RoozbehAmini/NTC-Thermistor-Temperature-Measurement-and-Calibration-System/Lab6_Project_Report.pdf

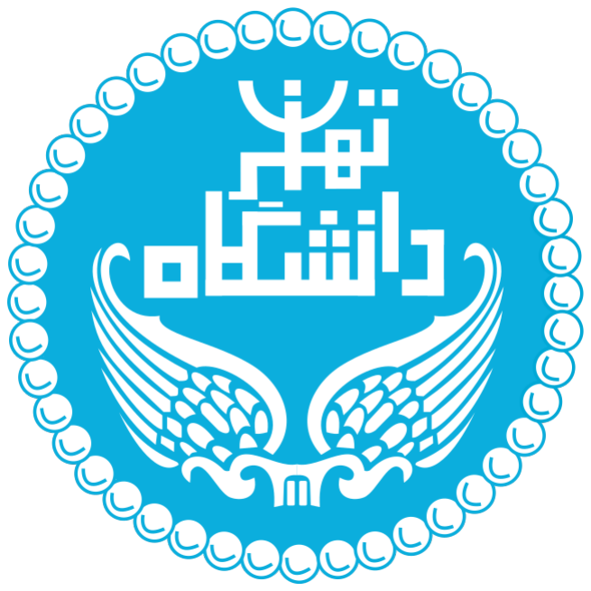
[picture p1: figure]

# Measurement Systems

# Lab Report 6

## Instructor: Dr. Ali Sadighi

## Author: Roozbeh Amini - 810601291

February 19, 2026

Session #6: Thermistor Temperature Measurement Measurement Systems Lab Report

Abstract

This report describes the design, calibration and verification of a temperature measurement system for 0–100 °C, built around a 10 kΩ NTC thermistor, a unity-gain difference amplifier and an Arduino Uno. The only reference thermometer available was a medical thermometer that reads between 32 and 43 °C, so all intermediate calibration points had to be taken in that range. The 0 °C point came from an ice bath. The high-end point came from boiling water, whose temperature was estimated as about 90 °C because of Tehran’s altitude and the cooling of the water after boiling. Eight calibration points were recorded at 50 Hz for 60 s each, and the mean of the last 10 s of each record was used as the steady-state value.
The ice bath reading, Vth(0 °C) = 3.73 V, was used as the reference voltage of the difference amplifier (Figure 8). Fitting the β-parameter model gave β = 3578.29 K and R0 = 9835.46 Ω. Evaluating the model at 100 °C gives Vth(100 °C) = 0.405 V and an amplifier output of 3.325 V. This value was used as the external ADC reference (VAREF = 3.325 V), so the full ADC range covers 0–100 °C with a resolution of 3.25 mV per step, 33.5% finer than with the default 5 V reference. The 1 MΩ amplifier input resistors are about 134 times the worst-case source impedance of the divider (7 468 Ω), well above the usual 10× rule. In the final test, the system read +0.44 °C in the ice bath and 34.32 °C in a bath where the medical thermometer read 34.4 °C, a difference of 0.08 °C.

## Contents

1 Introduction | 5
2 Theoretical Background | 5
3 Thermistor Calibration | 10
4 Circuit Design and Signal Conditioning | 21

5 Firmware Implementation | 29
6 Results and Verification | 30
7 Discussion | 31
8 Conclusion | 34
Acknowledgements | 35
Appendices | 37
A Arduino Calibration Logger (50 Hz, 60 s) | 37
B Live Voltage Reader | 38
C MATLAB Calibration Acquisition Script | 39
D MATLAB Model Fitting and Characteristic Plots | 41
E Final Temperature Measurement Firmware | 44

## List of Figures

1 | Typical NTC thermistor resistance vs. temperature characteristic [1]. . . . | 5
2 | The 10 kΩ NTC thermistor used in this experiment | | 6
3 | Voltage divider schematic: two series resistors between Vcc and GND pro-
| duce a node voltage proportional to the lower resistance | | 7
4 | Wheatstone bridge schematic [1]. At balance the differential voltage is
| VD = 0. When the bridge is unbalanced, as in sensor applications, VD
| changes with the deviation of Rx from its nominal value | | 8
5 | Difference amplifier schematic [1]. With all four resistors equal the output
| is Vout = V2 − V1 | | 9
6 | Three-op-amp instrumentation amplifier topology [1]. The gain is set by
| the single resistor RG | | 9
7 | Calibration setup. Both sensors were kept in the bath until the medical
thermometer showed a stable reading, and then the 60 s recording was started. 12
8 | 60 s recording at 0 °C (ice bath). The rising transient is the thermistor
| cooling from room temperature. Steady-state mean: Vth = 3.7300 V, Rth =
29,498.05 Ω | 14
9 | 60 s recording at 33.2 °C. Steady state: Rth = 7,241.27 Ω | 15
10 | 60 s recording at 34.4 °C. Steady state: Rth = 6,832.37 Ω | 15
11 | 60 s recording at 35.3 °C. Steady state: Rth = 6,585.11 Ω | 16
12 | 60 s recording at 37.0 °C. Steady state: Rth = 6,135.16 Ω | 16
13 | 60 s recording at 37.8 °C. Steady state: Rth = 5,944.50 Ω | 17
14 | 60 s recording at 38.2 °C. Steady state: Rth = 5,892.11 Ω | 17
15 | 60 s recording in boiling water (estimated 90 °C). The sharp initial drop
| is followed by a flat plateau. Steady state (last 10 s): Vth = 0.5100 V,
Rth = 1,135.84 Ω | 18
16 Calibration curve: measured points (red) and fitted β-model (blue). The
model is extrapolated to 100 °C to find VAREF | 19
17 | Expected thermistor characteristics from the fitted model over 0–100 °C.
| Left: resistance R(T). Right: divider output Vth(T) for Vcc = 5 V and
R1 = 10 kΩ. The calibration points are shown on both plots | 20
18 Stage 1 thermistor voltage divider wiring. The Vth node is connected by a
jumper to the inverting input of Stage 3 | 22
19 | Stage 3 difference amplifier wiring. All four resistors are 1 MΩ. Inverting
| input: Vth from Stage 1. Non-inverting input: Vref = 3.73 V from Stage 2.
Output to Arduino A0 | 24
20 Stage 4 AREF wiring, with the 5 kΩ protection resistor between the po-
tentiometer wiper and the AREF pin | 27
21 | Complete measurement circuit: (a) schematic and (b) breadboard. The
| breadboard follows the left-to-right order of the schematic. A walkthrough
video is available at [4] | 28

## 1. Introduction

NTC (negative temperature coefficient) thermistors are common in mechatronic instrumentation because they are sensitive, cheap and small [1]. Their resistance changes with temperature in a strongly nonlinear way, so a calibration model and some signal conditioning are needed before the signal can be read by a microcontroller ADC.

This report follows the workflow given in the course manual [1]: characterising the thermistor, designing the signal conditioning circuit and checking its loading, fitting a model in MATLAB, and running calibrated firmware on an Arduino Uno. Calibration is presented before the circuit design, because the two design voltages come from it: the difference amplifier reference Vref = 3.73 V and the external ADC reference VAREF = 3.325 V are both based on the calibration measurements and the fitted model. Neither can be taken from the thermistor datasheet alone.

### 1.1. Session Objectives

1. Understand how NTC thermistors work and how the β-parameter model describes them.
2. Design and build a voltage divider, a difference amplifier and an external ADC reference for the thermistor signal.
3. Collect calibration points, fit the β model by linearised least squares in MATLAB, and use the model to choose the ADC reference voltage.
4. Upload calibrated firmware to the Arduino Uno and check that the system works as a thermometer.

## 2. Theoretical Background

### 2.1. NTC Thermistor Characteristics

An NTC thermistor is a semiconductor resistor whose resistance drops sharply as temperature rises [1]. At higher temperatures more electrons are thermally excited into the conduction band, which increases the conductivity and lowers the resistance. This makes the thermistor very sensitive, but also strongly nonlinear, as Figure 1 shows. The thermistor used here (Figure 2) has a nominal resistance of 10 kΩ at 25 °C.

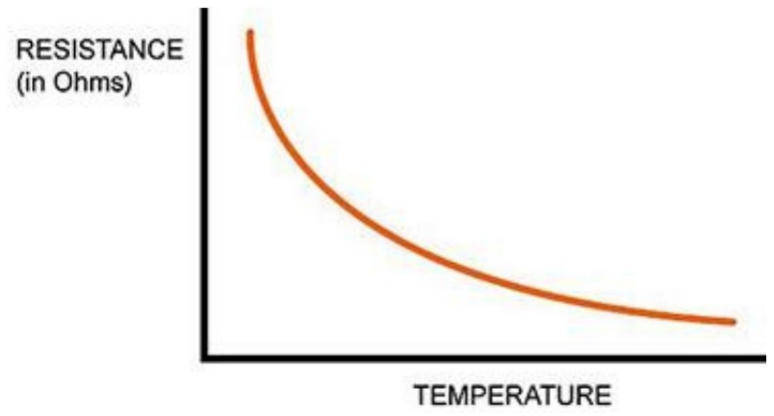
[picture p2: figure]

Figure 1: Typical NTC thermistor resistance vs. temperature characteristic [1].

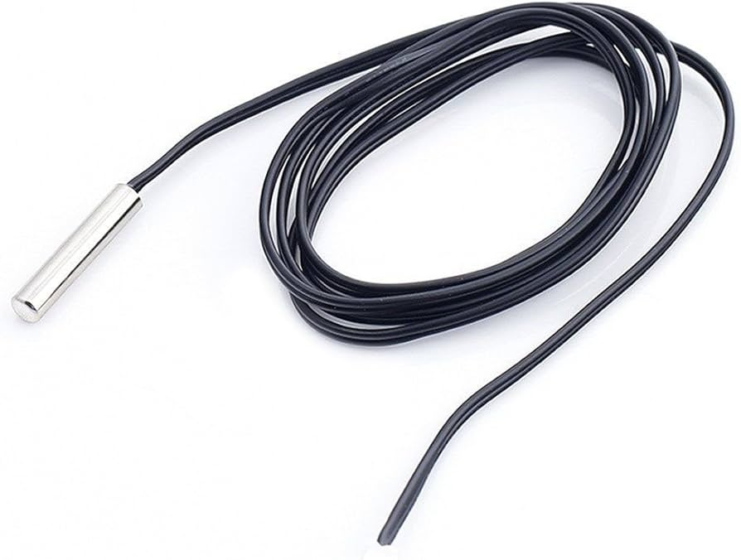
[picture p3: figure]

Figure 2: The 10 kΩ NTC thermistor used in this experiment.

### 2.2. The β-Parameter Equation

The lab manual [1] uses the β-parameter equation to describe the thermistor:

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
ln R
R0

(1)

Solving for resistance:

R(T) = R0 exp
β
1
T

−

1
T0
| (2)

where T0 = 298.15 K (25 °C) is the reference temperature, R0 is the resistance at T0, and β is a material constant, usually 3000–4000 K for NTC thermistors. Solving for temperature instead gives:

T =

1
1
T0

+

1
β

ln R
R0

(3)

### 2.2.1. Linearisation for Least-Squares Fitting

Taking the logarithm of Equation (2) gives a linear relation:

ln R
|{z}
y

= ln R0
| {z }
intercept

+β

1
T

−

1
T0

| | {z | }
| x

(4)

With xi = 1/Ti −1/T0 and yi = ln Ri
, this is the straight line y = β x+ln R0. MATLAB’s polyfit(x,y,1) fits it by ordinary least squares and returns the slope βˆ and the intercept ln Rˆ

0, so Rˆ
0 = exp(intercept).

### 2.3. Voltage Divider

### 2.3.1. General Principle

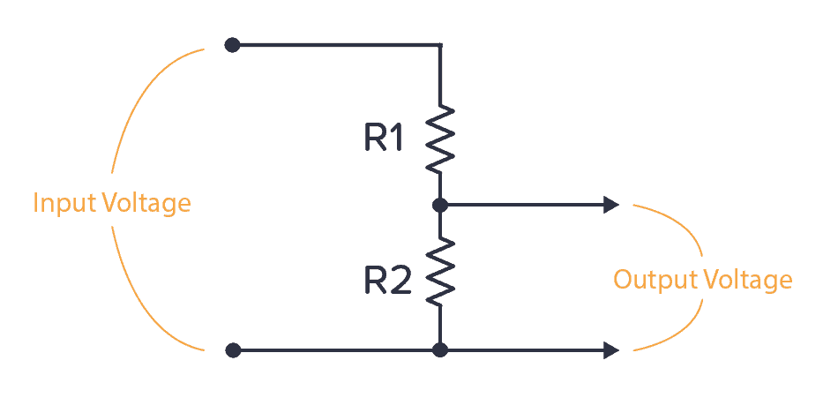
[picture p4: figure]

Figure 3: Voltage divider schematic: two series resistors between Vcc and GND produce a node voltage proportional to the lower resistance.

As shown in Figure 3, two resistors in series divide the supply voltage:

Vout = Vcc ·

R2
R1 + R2

(5)

Any load connected to the output node is in parallel with R2. This lowers the effective lower resistance and pulls Vout below its ideal value. This loading effect is calculated in Section 2.3.4.

### 2.3.2. Thermistor Voltage Divider

With the thermistor as the lower resistor (R2 = Rth, R1 = 10 kΩ, Vcc = 5 V):

Vth = Vcc ·

Rth
R1 + Rth

, Rth = R1 ·

Vth
Vcc − Vth

(6)

Since the NTC resistance falls with temperature, Vth falls too. At 0 °C (Rth ≈ 29,500 Ω) the node is at about 3.73 V, and at 100 °C (Rth ≈ 881 Ω, from the model) it drops to 0.405 V.

### 2.3.3. Potentiometer as an Adjustable Voltage Divider

A potentiometer splits its total resistance Rtotal into an upper part Rtop and a lower part Rbot. With its two ends connected to Vcc and GND, the wiper voltage is:

Vwiper = Vcc ·

Rbot

Rtotal

(7)

Turning the adjustment screw changes Rbot, so the wiper voltage can be set anywhere between 0 and Vcc. Two potentiometers were used this way: potentiometer 1 for the

3.73 V amplifier reference and potentiometer 2 for the 3.325 V ADC reference. Both were set using a live voltage reader sketch on the Arduino.

### 2.3.4. Impedance Loading and the 10× Rule

The Thévenin output impedance of the divider is:

RTh = R1 ∥ Rth =

R1Rth
R1 + Rth

(8)

When a load RL ≫ RTh is connected, the voltage error is approximately:

εV ≈ Vth ·

RTh
RL

(9)

The usual 10× rule limits this error to about 10% of Vth (about 9% if calculated exactly):

RL ≥ 10 RTh | (10)

### 2.4. Wheatstone Bridge

A Wheatstone bridge (Figure 4) measures an unknown resistance by balancing two legs of a four-resistor network [1]. At balance:

Rx =

R2
R1
- R3 | (11)

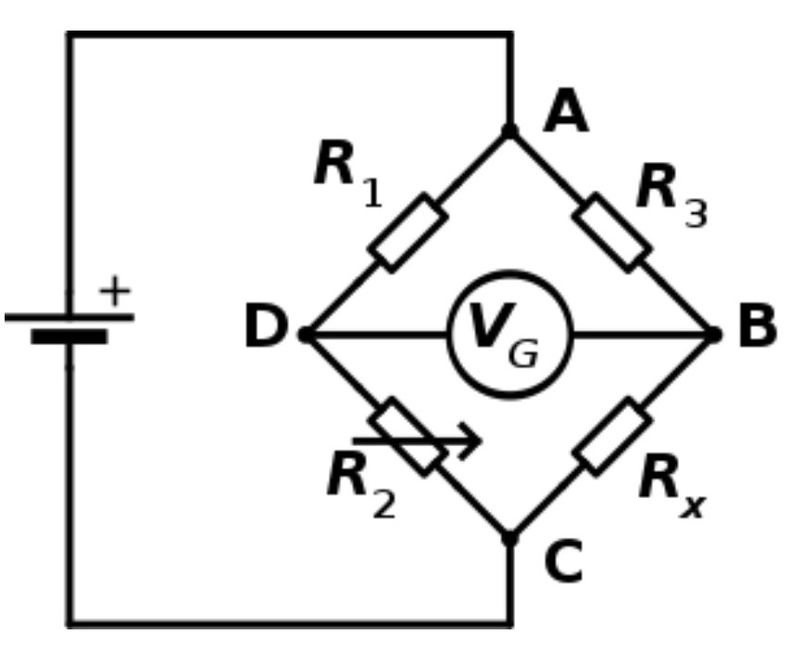
[picture p5: figure]

Figure 4: Wheatstone bridge schematic [1]. At balance the differential voltage is VD = 0. When the bridge is unbalanced, as in sensor applications, VD changes with the deviation of Rx from its nominal value.

When the bridge is not balanced, the voltage between its two midpoints depends on how far Rx is from its reference value. The circuit in this experiment gets the same kind of differential measurement in a simpler way: a difference amplifier subtracts Vth from a fixed reference voltage, so a full four-resistor bridge is not needed.

### 2.5. Difference Amplifier

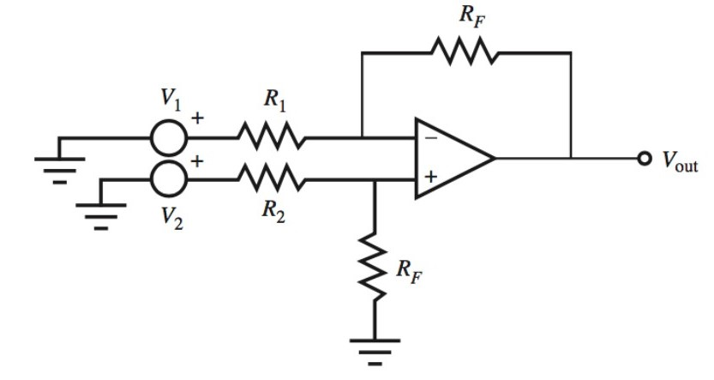
[picture p6: figure]

Figure 5: Difference amplifier schematic [1]. With all four resistors equal the output is Vout = V2 − V1.

The difference amplifier (Figure 5) subtracts two voltages, with a gain set by the resistor ratio [1, 2]:

Vout =

RF

Rin

(V2 − V1) | (12)

With all four resistors equal (RF = Rin), the gain is one:

Vout = V2 − V1 | (13)

Here V2 = Vref = 3.73 V (potentiometer 1) and V1 = Vth (the thermistor divider node), so the output shows how far the thermistor voltage has moved from its 0 °C value.

### 2.6. Instrumentation Amplifier

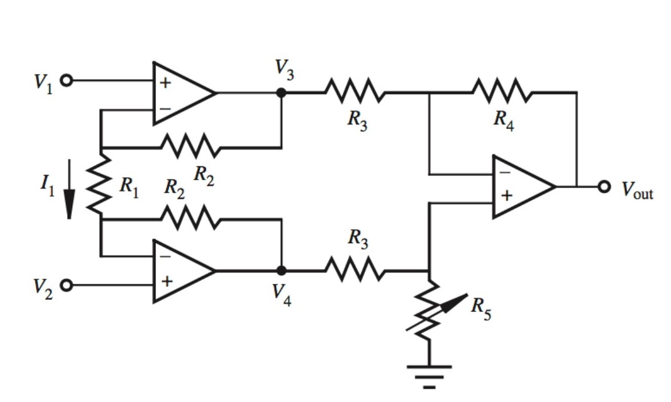
[picture p7: figure]

Figure 6: Three-op-amp instrumentation amplifier topology [1]. The gain is set by the single resistor RG.

An instrumentation amplifier (Figure 6) has buffered inputs, so its input impedance is very high and loading is not a concern. Its gain is set by a single resistor:

G = 1 +

2R
RG

(14)

Alternative Implementations

Instrumentation amplifier (e.g. AD620 [3]): would remove the loading error and allow a gain above 1 with a single external resistor.
Dual DC supply: with a ±9 V or ±12 V supply, the op-amp output could swing over the whole ADC range, and the external AREF potentiometer would not be needed. Section 4.4.6 explains why a gain stage was not used instead.

### 2.7. ADC Reference Voltage and Resolution

The Arduino Uno’s 10-bit ADC maps [0, VAREF] to [0, 1023] [1]:

Vmeasured =

ADC
1023
- VAREF, ∆V =

VAREF
1023

(15)

With the default 5 V reference and a signal between 0 and 3.325 V, only 680 of the 1023 steps (66.5%) are used. With VAREF = 3.325 V all 1023 steps are used, and the step size drops to 3.25 mV, a 33.5% improvement over the default.

## 3. Thermistor Calibration

Calibration comes before the circuit design in this report because both design voltages come from it. Vref = 3.73 V is the ice bath reading, and VAREF = 3.325 V is the fitted model’s prediction at 100 °C. Neither value can be read from the thermistor datasheet.

### 3.1. Calibration Strategy and Instrument Constraints

The calibration was limited by the reference instrument available: a standard digital medical thermometer. It is easy to get and accurate around body temperature, but it only reads between about 32 °C and 43 °C. Outside this range it shows Lo (below 32 °C) or Hi (above 43 °C) and cannot be used as a reference.

This is why the calibration points are spread the way they are:

- Intermediate points (33–38 °C): taken in mixtures of cold and hot water, inside the thermometer’s range. The six points are close together only because of this limit.
- 0 °C (ice bath): taken without the thermometer. The melting point of ice at atmospheric pressure is a fixed point and needs no reference instrument.
- ≈90 °C (boiling water): taken without the thermometer, since this temperature is above its range. The temperature was therefore estimated, as explained in Section 3.2.

Ideally the points would be spread evenly over 0–100 °C (for example at 0, 15, 30, 45, 60, 75 and 90 °C), but that would need a calibrated thermocouple or platinum RTD. Section 7.1 discusses how this affects the model.

### 3.2. Reference Temperature Sources

1. Ice bath, 0 °C (fixed point). A well-stirred mixture of crushed ice and distilled water. Its temperature is within about 0.05 °C of 0 °C, so no reference instrument is needed. This was the first measurement, and its steady-state reading (Vth = 3.73 V, Figure 8) sets Vref for the difference amplifier.
2. Boiling water, estimated 90 °C. Water was boiled in an electric kettle, the probe was put in right away, and the 60 s recording was started. The water temperature could not be measured, because it is above the thermometer’s range, so it was estimated as 90 °C instead of 100 °C, for two reasons:
- Tehran’s altitude. At about 1200–1500 m above sea level, the atmospheric pressure is about 0.83–0.87 atm. The boiling point of water drops by about 0.34 °C per 100 m, so it is 4–5 °C lower here.
- Cooling after the kettle is unplugged. The water starts losing heat as soon as the kettle is unplugged, so it was assumed to be a few degrees below its boiling point during the measurement.

Because this value is an estimate, its uncertainty is listed as an error source in Section 7.3. The point is used as the high-end anchor of the β fit. The ADC reference is not taken from this point directly; it comes from extrapolating the fitted model to 100 °C (Section 3.9).

3. Mixed baths, 33–38 °C. Cold and hot water mixed in different proportions, with the medical thermometer in the same bath. Only readings inside the thermometer’s 32–43 °C range were used.

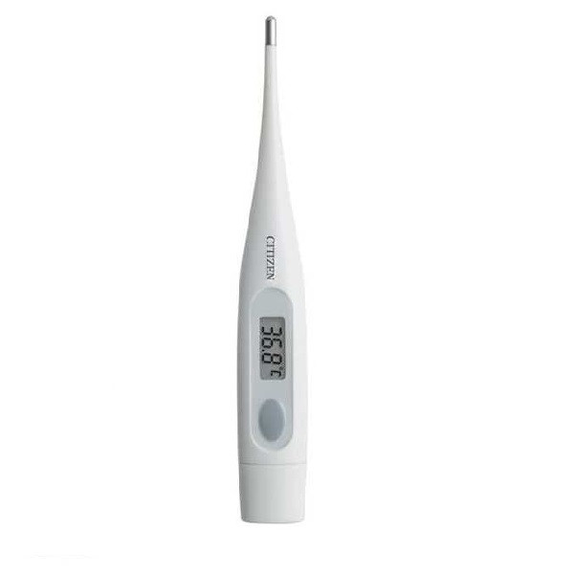
[picture p8: figure]

(a) Medical thermometer (valid range 32– 43 °C).

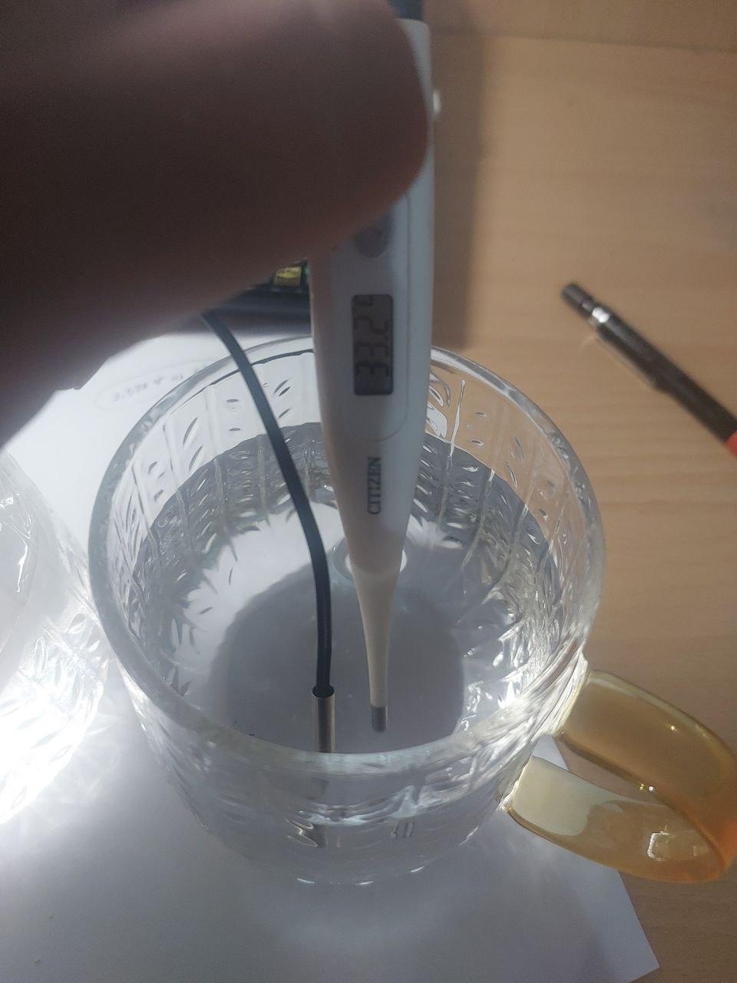
[picture p9: figure]

(b) Thermistor and thermometer in the same bath.

Figure 7: Calibration setup. Both sensors were kept in the bath until the medical thermometer showed a stable reading, and then the 60 s recording was started.

### 3.3. Data Collection: 50 Hz Arduino Logger

For each calibration point, an Arduino sketch sampled the thermistor voltage at 50 Hz (every 20 ms) for 60 s and sent the data over serial at 115200 baud as comma-separated values. The sampling is timed with millis() instead of delay(), so the sample spacing does not drift:
Listing 1: Core 50 Hz acquisition loop. The resistance is computed on the Arduino by inverting the voltage divider (Eq. (6)).
1 | while ( millis () - t0 < DURATION_MS ) {
2 | if ( millis () >= next ) {
3 | next += Ts_ms ; | // 20 ms -> 50 Hz
4 | float t_s = ( millis () - t0) / 1000.0 f;
5 | int | adc = analogRead ( THERM_PIN ) ;
6 | float v | = adc * VREF / 1023.0 f;
7 | float Rth = (v > 0.01 f && v < VREF - 0.01 f)
8 | ? R_FIXED * v / ( VREF - v)
9 | : 0.0f;
10 | Serial . print (t_s , 4) ; Serial . print (",") ;
11 | Serial . print (adc) ; | Serial . print (",") ;
12 | Serial . print (v, 6) ; | Serial . print (",") ;
13 | Serial . println (Rth , 2) ;
14 | }
15 | }

The full logger sketch is given in Appendix A.

### 3.4. Steady-State Analysis in MATLAB

MATLAB reads each 3000-sample record through the serialport interface. The last 10 s (500 samples) are used as the steady-state window, since by then the thermistor has settled at the bath temperature. Their mean and standard deviation are computed as follows:

Listing 2: Steady-state extraction in MATLAB: the last steady_win seconds are averaged.

1 | t_max | = max (T);
2 | ss | = T >= ( t_max - steady_win ) ; | % last 10 s
3 | v_mean = mean (V(ss) ) ;
4 | r_mean = mean (R(ss) ) ;
5 | r_std | = std (R(ss) ) ;

Each recording is plotted with the raw 50 Hz signal (grey), a 1 s moving average (coloured), the steady-state window (green) and the mean (dashed line), so any transient that has not died out can be seen before a point is accepted. The full script is given in Appendix C.

### 3.5. Calibration Dataset

Table 1: The eight calibration points. Rth is the mean of the last 10 s of each 60 s record.

Pt Tref (°C) T (K) | Rth (Ω) | Source
1 | 0.0 | 273.15 29 498.05 | Ice bath
2 | 33.2 | 306.35 | 7 241.27 | Mixed + therm.
3 | 34.4 | 307.55 | 6 832.37 | Mixed + therm.
4 | 35.3 | 308.45 | 6 585.11 | Mixed + therm.
5 | 37.0 | 310.15 | 6 135.16 | Mixed + therm.
6 | 37.8 | 310.95 | 5 944.50 | Mixed + therm.
7 | 38.2 | 311.35 | 5 892.11 | Mixed + therm.
8 | 90.0 | 363.15 | 1 135.84 | Boiling water (est.)

### 3.6. Steady-State Acquisition Plots and Observations

Figures 8–15 show the 60 s recordings for all eight calibration points. Each figure shows the raw 50 Hz signal (grey), a 1 s moving average (coloured line), the steady-state window (green shading) and the steady-state mean (dashed line).

Ice bath, 0 °C (Figure 8). The thermistor went into the ice bath from room temperature (about 25 °C). Since the NTC resistance increases as the temperature falls, Vth rises during the first 20–25 s as the thermistor cools, from about 2.48 V at 25 °C to 3.73 V at 0 °C, a change of +1.25 V. The last 10 s show a stable, low-noise plateau with a mean of Vth = 3.7300 V, which is used directly as Vref = 3.73 V in the difference amplifier (Step 1, Section 3.9).

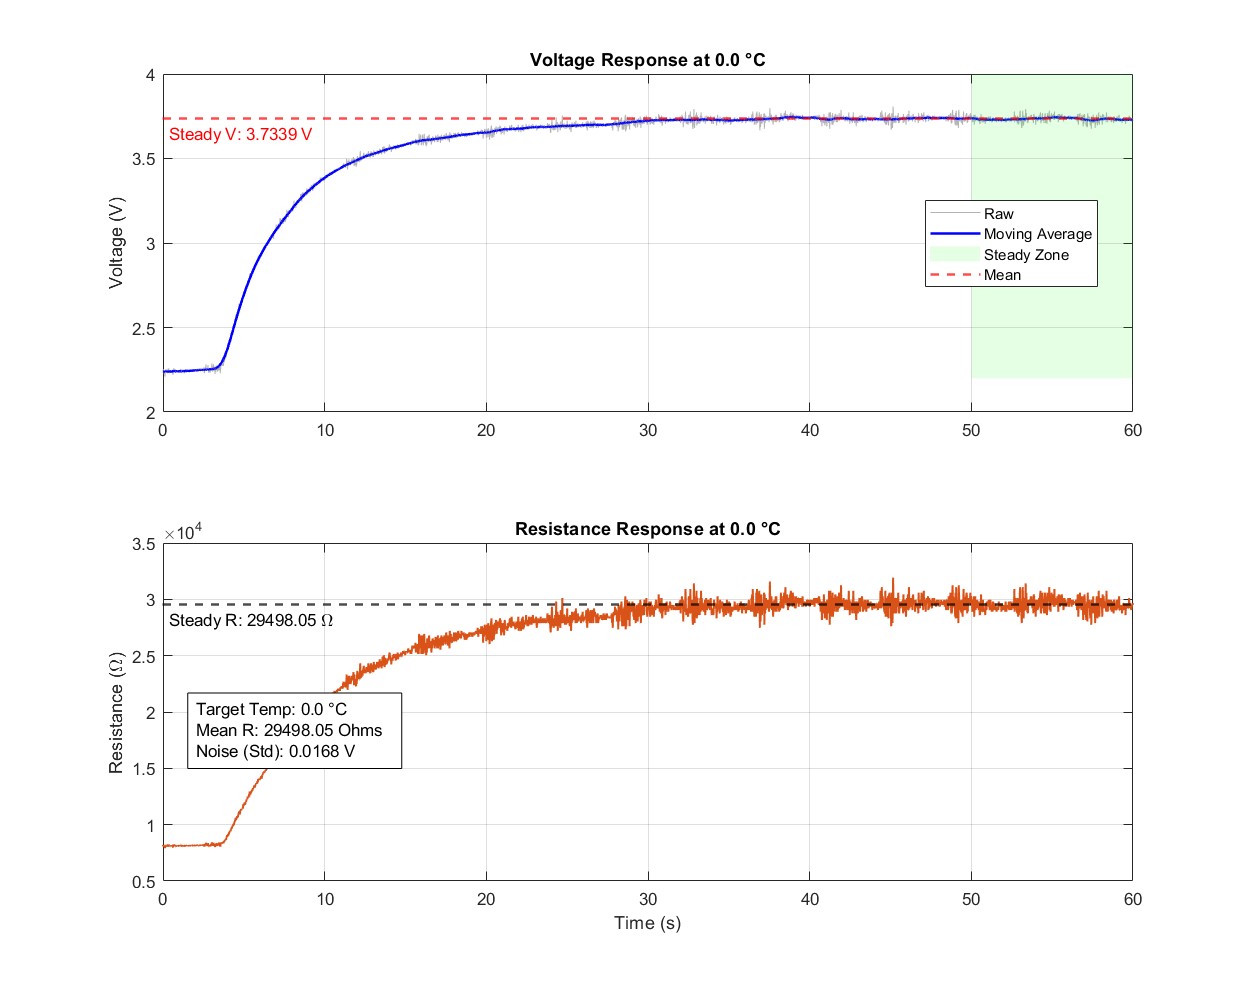
[picture p10: figure]

Figure 8: 60 s recording at 0 °C (ice bath). The rising transient is the thermistor cooling from room temperature. Steady-state mean: Vth = 3.7300 V, Rth = 29,498.05 Ω.

Mixed baths, 33–38 °C (Figures 9–14). These recordings settle much faster than the ice bath, because the thermistor starts only 8–13 °C away from the bath temperature, compared with 25 °C for the ice bath. The reading settles within 5–10 s, and the remaining 50 s are flat. As the bath temperature increases, Vth decreases from about 2.10 V at 33.2 °C to about 1.85 V at 38.2 °C, as expected for an NTC thermistor. The small standard deviation in each 10 s window shows that the thermistor had settled and the ADC signal was stable.

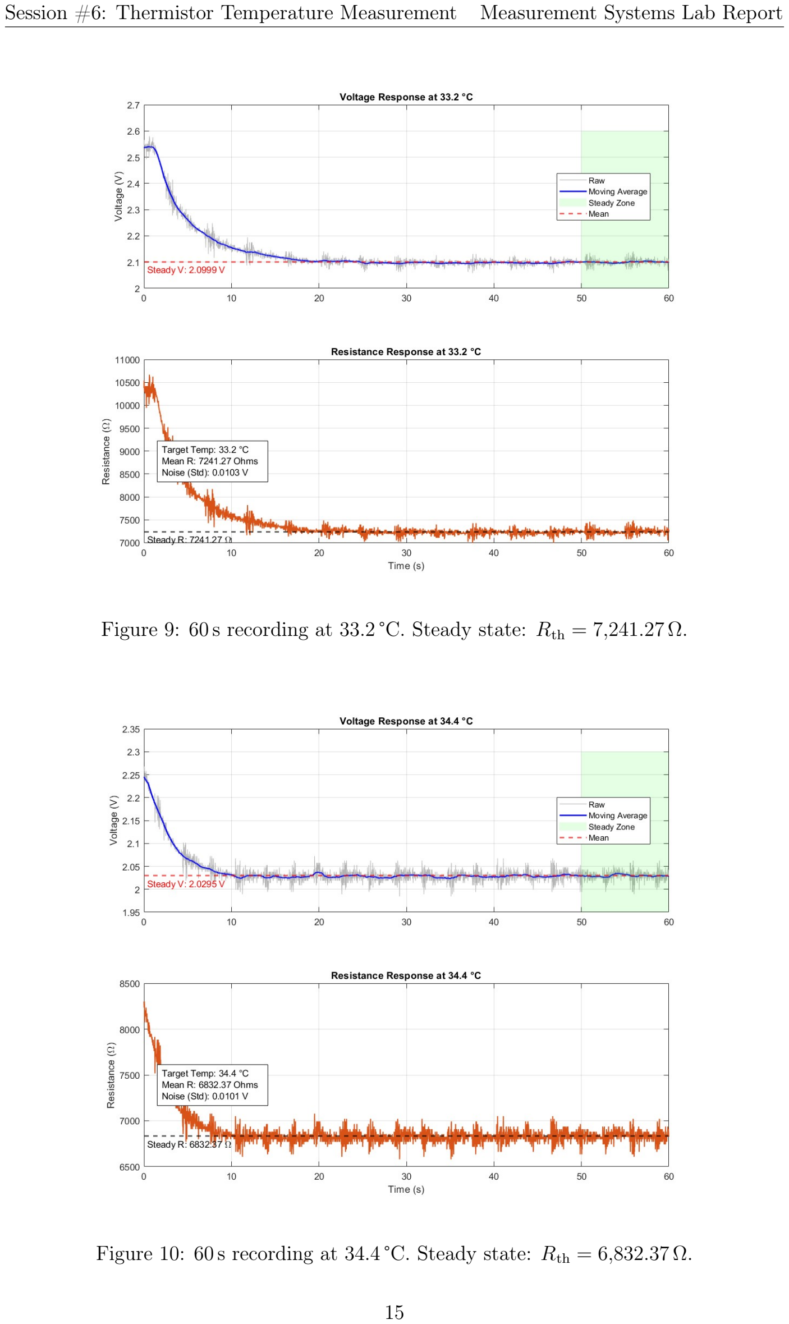
[picture p11: page 16]

Figure 9: 60 s recording at 33.2 °C. Steady state: Rth = 7,241.27 Ω.

Figure 10: 60 s recording at 34.4 °C. Steady state: Rth = 6,832.37 Ω.

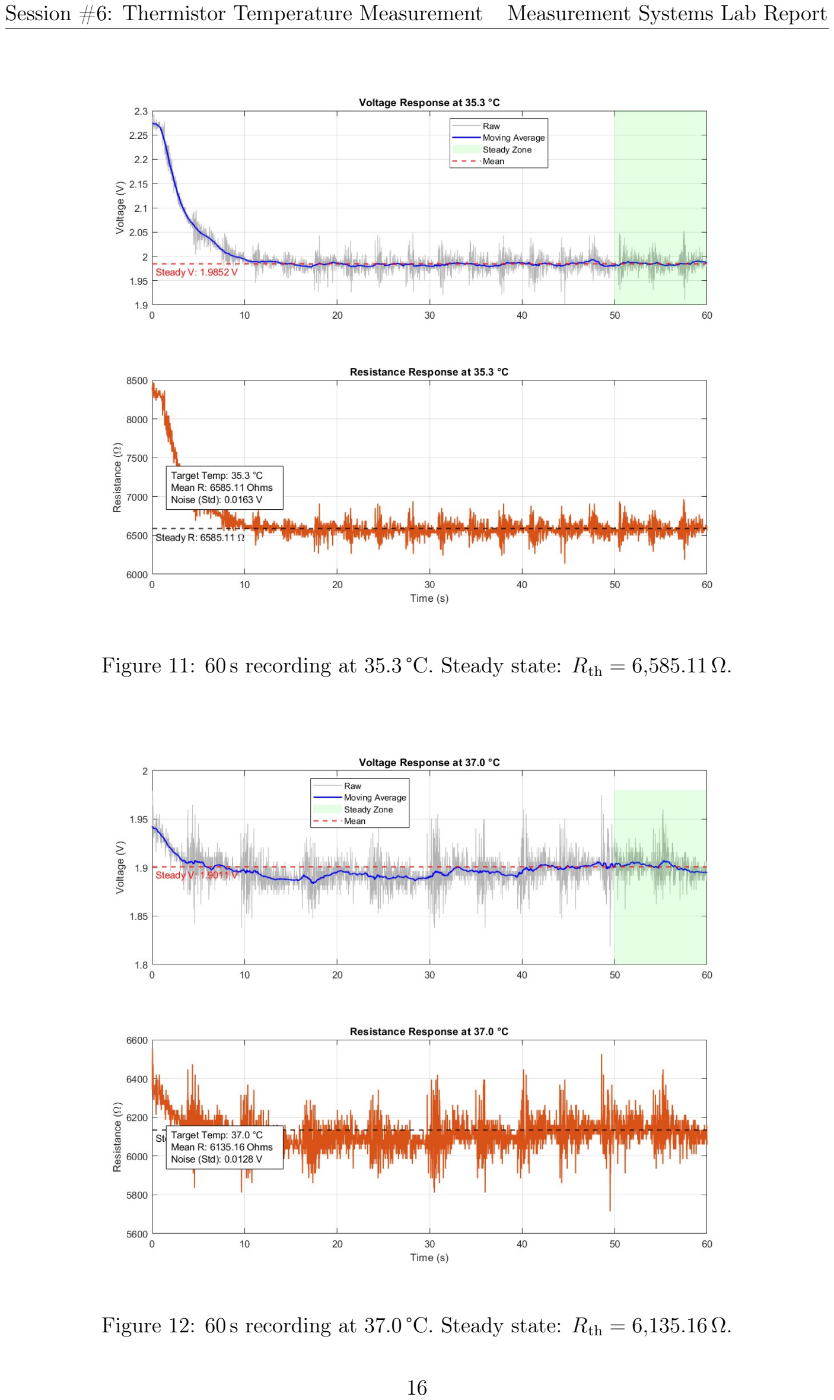
[picture p12: page 17]

Figure 11: 60 s recording at 35.3 °C. Steady state: Rth = 6,585.11 Ω.

Figure 12: 60 s recording at 37.0 °C. Steady state: Rth = 6,135.16 Ω.

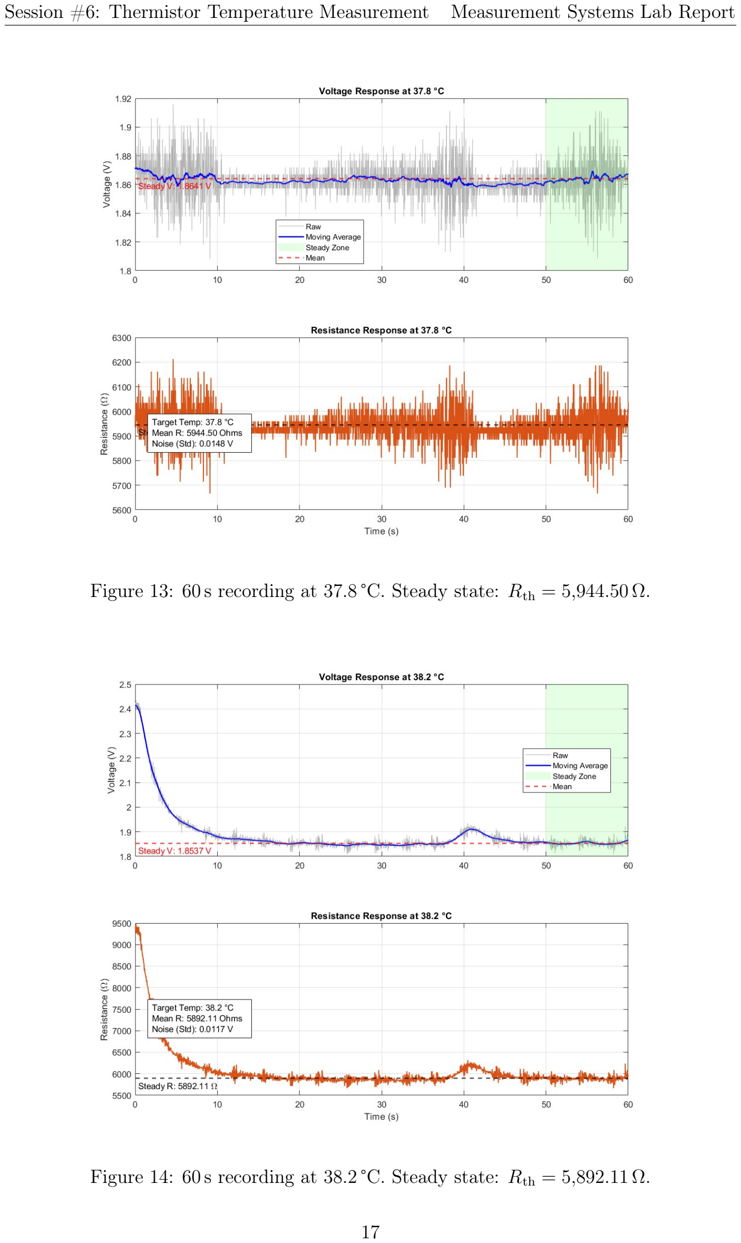
[picture p13: page 18]

Figure 13: 60 s recording at 37.8 °C. Steady state: Rth = 5,944.50 Ω.

Figure 14: 60 s recording at 38.2 °C. Steady state: Rth = 5,892.11 Ω.

Boiling water, about 90 °C (Figure 15). Here the thermistor goes from room temperature into very hot water. The resistance drops sharply in the first 5 s, and Vth falls from about 2.48 V to about 0.51 V, a drop of about 1.97 V. After about 15 s the reading levels off, and the last 10 s show a stable plateau, which means the thermistor has reached the bath temperature. The steady-state mean is Vth = 0.5100 V and Rth = 1,135.84 Ω. This point is the high-end anchor of the β fit. The AREF voltage is found later by extrapolating the fitted model to 100 °C (Section 3.9).

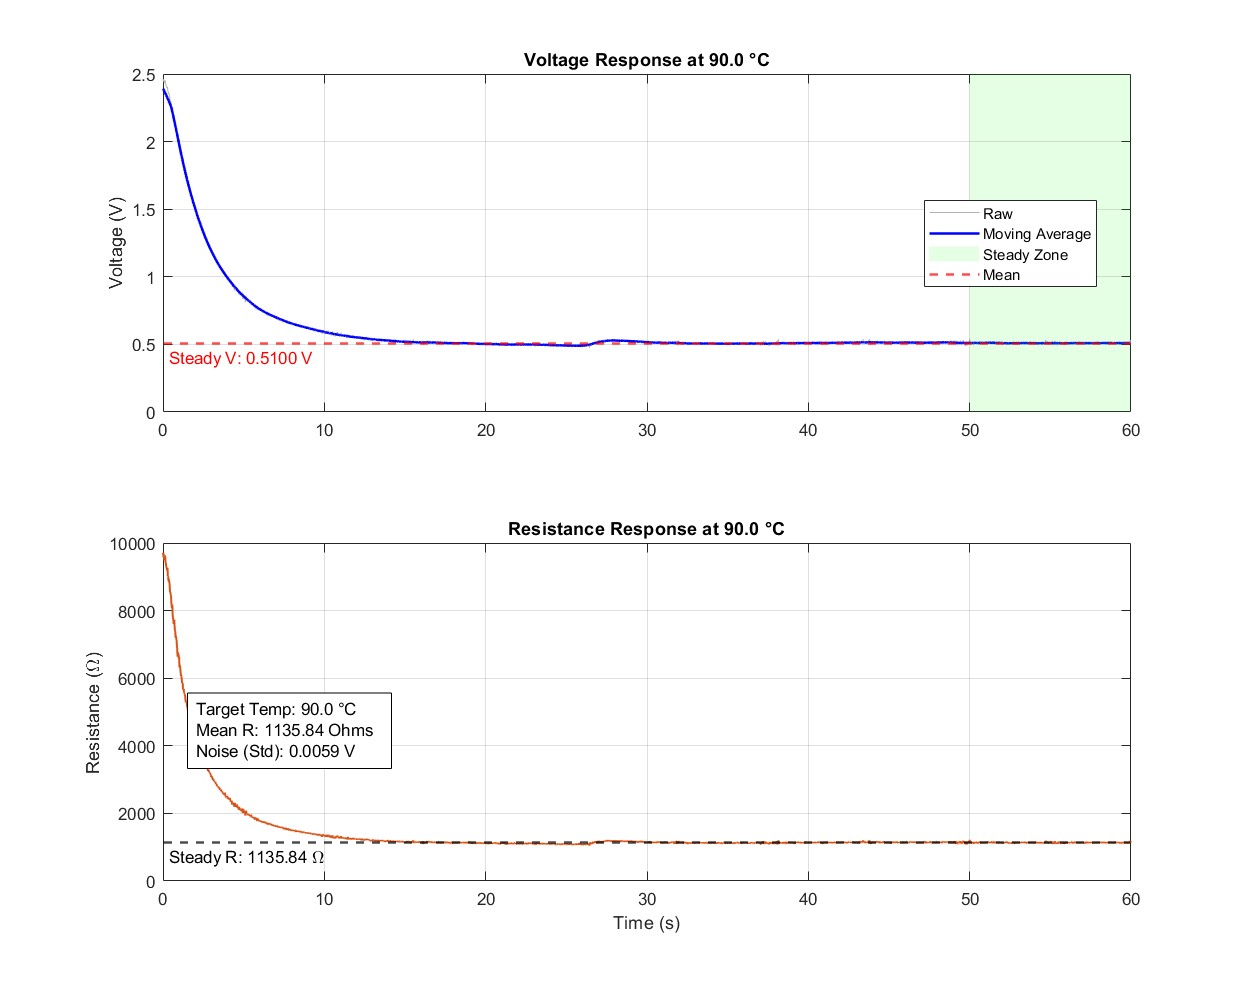
[picture p14: figure]

Figure 15: 60 s recording in boiling water (estimated 90 °C). The sharp initial drop is followed by a flat plateau. Steady state (last 10 s): Vth = 0.5100 V, Rth = 1,135.84 Ω.

### 3.7. β-Model Fitting

The calibration pairs (Ti

, Ri) from Table 1 are converted to the linear form of Equation (4) and fitted in MATLAB:

Listing 3: Linearised β-model fit.

1 | X | = (1 ./ T_K ) - (1 / T0) ;
2 | Y | = log ( R_meas ) ;
3 | p | = polyfit (X, Y, 1) ;
4 | Beta = p (1) ;
5 | R0 | = exp (p(2) ) ;

The full script is given in Appendix D.

### 3.8. Fitted Model Parameters and Calibration Curve

β = 3578.29 K, | R0 = 9835.46 Ω | (16)

The fitted β = 3578 K is inside the usual 3000–4000 K range for NTC thermistors, and R0 = 9835.46 Ω is within 1.65% of the nominal 10 kΩ, so both values are reasonable. Figure 16 shows the fitted curve with all eight calibration points.

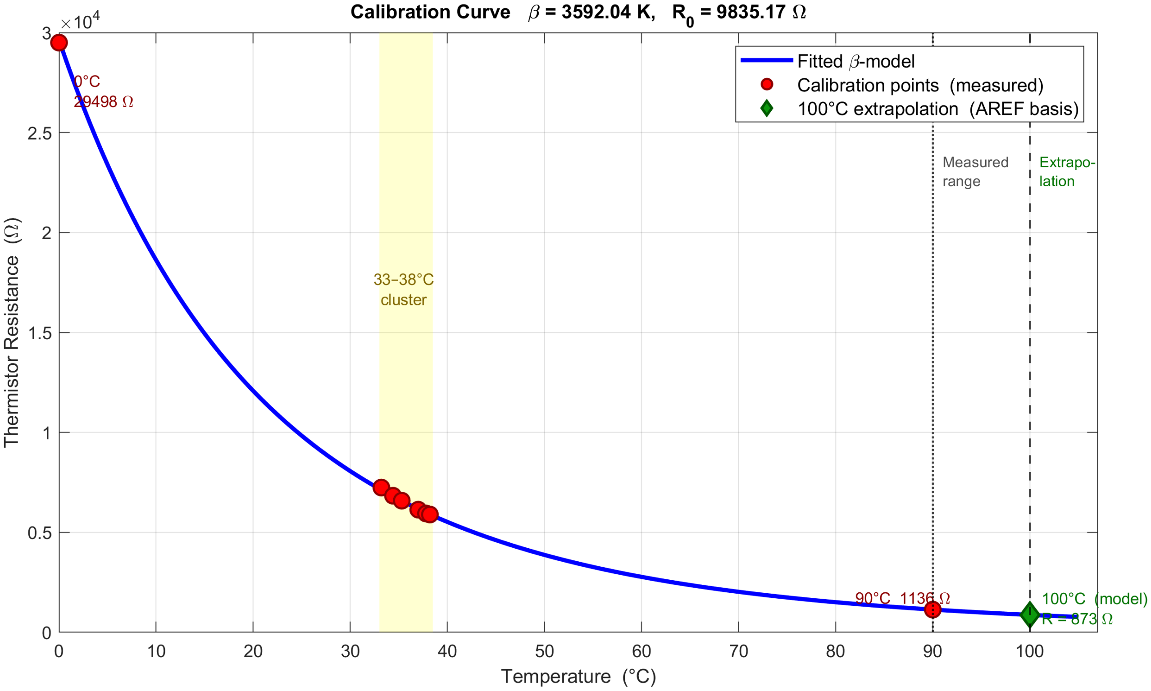
[picture p15: figure]

Figure 16: Calibration curve: measured points (red) and fitted β-model (blue). The model is extrapolated to 100 °C to find VAREF.

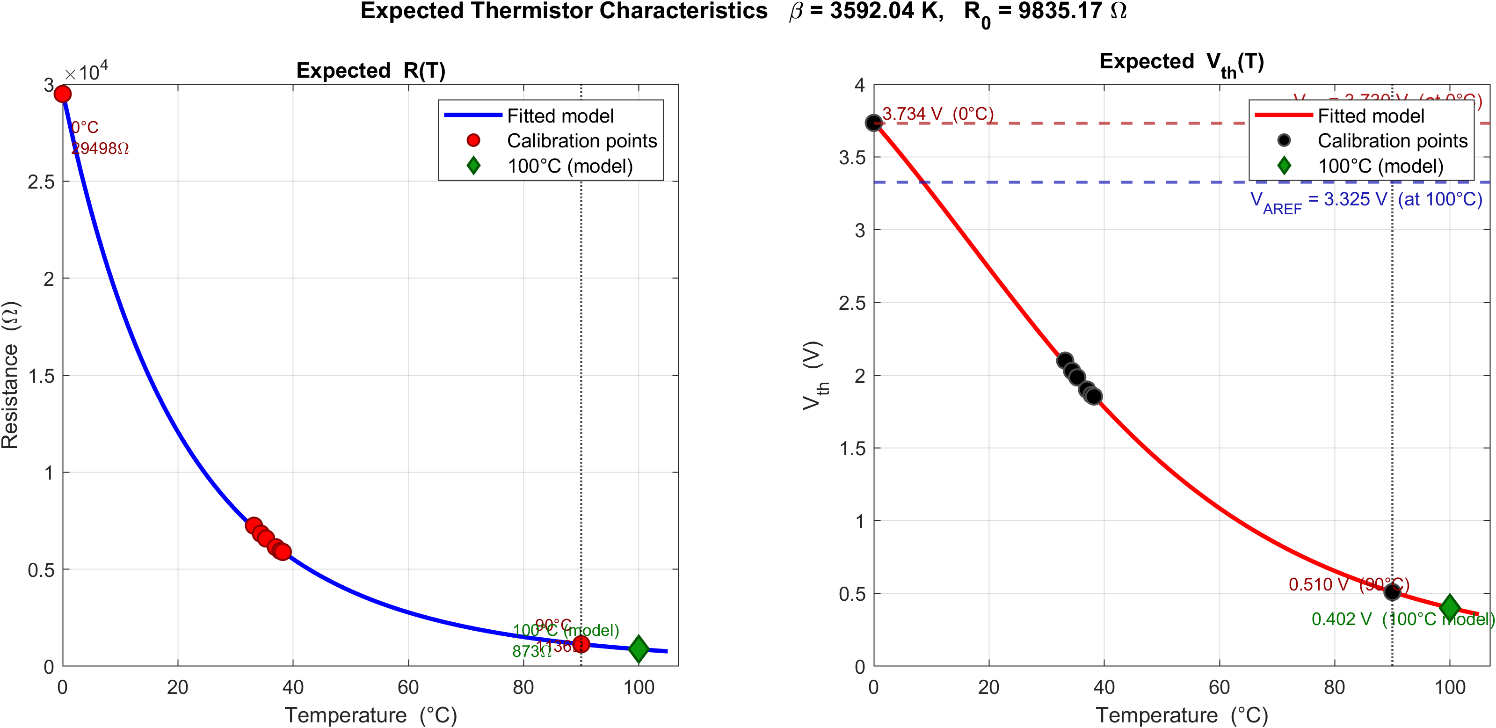
[picture p16: figure]

Figure 17: Expected thermistor characteristics from the fitted model over 0–100 °C. Left: resistance R(T). Right: divider output Vth(T) for Vcc = 5 V and R1 = 10 kΩ. The calibration points are shown on both plots.

Figure 17 shows the expected R(T) and Vth(T) curves from the fitted model. The eight calibration points lie close to both curves, which supports the model inside the calibrated range.

### 3.9. Calculation of the Design Voltages

Both design voltages are calculated from the calibration data and the fitted model.

### 3.9.1. Step 1: Ice Bath ⇒ Vref = 3.73 V

The plateau in Figure 8 gives Vth(0 °C) = 3.7300 V. Using the measured steady-state resistance in the divider equation (Equation (6)) gives almost the same value:

Vth(0 °C) = 5.0 ×

29,498
10,000 + 29,498
= 3.7341 V | (17)

The two values agree within 4 mV. For the difference amplifier output to be 0 V in the ice bath, its non-inverting input has to be at this voltage:

Vout(0 °C) = Vref − Vth(0 °C) = 3.73 − 3.73 = 0 V | (18)

So potentiometer 1 was set to Vref = 3.73 V.

### 3.9.2. Step 2: Extrapolation to 100 °C ⇒ VAREF = 3.325 V

Using the measured 90 °C point to set the ADC reference would limit the ADC range to 0–90 °C. Instead, the fitted model was evaluated at 100 °C, so that ADC full scale corresponds to the top of the intended 0–100 °C range.

Step 2a: Resistance at 100 °C from the model.

Substituting T = 373.15 K into Equation (2):

R(100 °C) = 9835.46×exp
3578.29 ×
1
373.15

−

1

298.15 = 9835.46×e
−2.412 = 881.4 Ω

(19)

Step 2b: Divider voltage at 100 °C.

Vth(100 °C) = 5.0 ×

881.4
10,000 + 881.4
= 0.4050 V | (20)
Step 2c: Difference amplifier output at 100 °C.
Vout(100 °C) = Vref − Vth(100 °C) = 3.730 − 0.405 = 3.325 V | (21)

This value was used as VAREF = 3.325 V on potentiometer 2, which gives the following ADC mapping:

- ADC = 0 ←→ Vout = 0 V ←→ 0 °C
- ADC = 1023 ←→ Vout = 3.325 V ←→ 100 °C (nominal)

### 3.9.3. Voltage Table at All Calibration Points

Table 2 lists the divider voltage and the expected amplifier output at the eight calibration points, plus the 100 °C model value that defines AREF.

Table 2: Expected voltages at each calibration point. The last row (100 °C) comes from the fitted model and defines VAREF.

Pt | T (°C) | Rth (Ω) | Vth (V) Vout = Vref − Vth (V)
1 | 0.0 | 29 498.05 | 3.7341 | ≈0.000
2 | 33.2 | 7 241.27 | 2.1000 | 1.630
3 | 34.4 | 6 832.37 | 2.0295 | 1.701
4 | 35.3 | 6 585.11 | 1.9852 | 1.745
5 | 37.0 | 6 135.16 | 1.9012 | 1.829
6 | 37.8 | 5 944.50 | 1.8641 | 1.866
7 | 38.2 | 5 892.11 | 1.8538 | 1.876
8 | 90.0 | 1 135.84 | 0.5100 | 3.220
100.0 (model) | 881.4 | 0.405 | 3.325 ← AREF

## 4. Circuit Design and Signal Conditioning

### 4.1. System Overview

The measurement chain has four stages in series. Stage 1 is the thermistor voltage divider, which turns resistance into voltage. Stage 2 is a potentiometer that gives a fixed 3.73 V reference. Stage 3 is a unity-gain difference amplifier that subtracts the thermistor voltage from this reference, so the output is 0 V at 0 °C and 3.325 V at 100 °C. Stage 4 puts 3.325 V on the Arduino AREF pin, so the 0–100 °C range uses all 1023 ADC steps.

### 4.2. Stage 1: Thermistor Voltage Divider

### 4.2.1. Circuit Description

The 10 kΩ series resistor (R1) goes between the Arduino 5 V rail and one lead of the thermistor, and the other thermistor lead goes to GND. The node between them carries the signal voltage Vth (Equation (6)).

### 4.2.2. Wiring on the Breadboard

- 5 V rail → R1 (10 kΩ): one leg of the resistor goes into a row connected to the 5 V rail.
- R1 → thermistor: the other leg of R1 and one thermistor lead share the same row. This row is the Vth node.
- Thermistor → GND rail: the second thermistor lead goes to the GND rail.
- Vth node → op-amp inverting input: a short jumper connects the Vth node to the 1 MΩ input resistor (Rin,inv) of the difference amplifier in Stage 3.

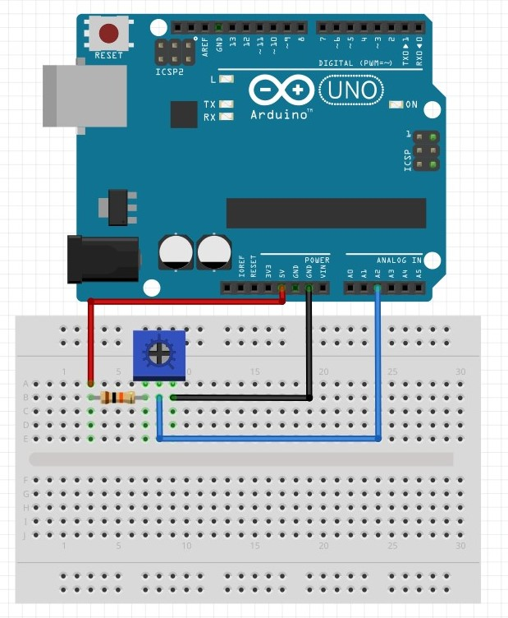
[picture p17: figure]

Figure 18: Stage 1 thermistor voltage divider wiring. The Vth node is connected by a jumper to the inverting input of Stage 3.

### 4.3. Stage 2: Reference Voltage Generator (3.73 V)

### 4.3.1. Circuit Description

A trimmer potentiometer provides the 3.73 V reference Vref for the difference amplifier. With its two ends connected to 5 V and GND, it works as an adjustable divider (Equation (7)), and the wiper can be set anywhere between 0 and 5 V.

### 4.3.2. Wiring on the Breadboard

- One end terminal → 5 V rail.
- Other end terminal → GND rail.
- Wiper → op-amp non-inverting input: the wiper (centre pin) goes to the 1 MΩ input resistor (Rin,non) on the non-inverting side of Stage 3.
- Wiper → Arduino A2 (optional monitor): a second jumper from the wiper to A2 lets the live voltage reader (Appendix B) show the wiper voltage while it is being adjusted.

### 4.3.3. Setting the Potentiometer with the Live Voltage Reader

While building the circuit, a short Arduino sketch printed the wiper voltage to the Serial Monitor at 2 Hz, and the screw was turned slowly until the reading settled at 3.73 V. Only the voltage column matters here; the resistance column is only meaningful for the thermistor divider (see the note in Appendix B).

Listing 4: Core of the live voltage reader used to set both potentiometers.

1 int | adc | = analogRead ( PIN_ANALOG ) ;
2 float Vout | = ( float )adc * VREF / ( float ) ADC_RES ;
3 float R_pot = -1.0f; | // -1 = out of range
4 if ( Vout > 0.01 f && Vout < VREF - 0.01 f)
5 R_pot = R_FIXED * ( VREF / ( VREF - Vout ) - 1.0 f) ;
6 Serial . print (Vout , 4) ; Serial . print (",") ;
7 Serial . println (R_pot , 2) ;

Serial Monitor output while setting the reference:

Vout [V] , R_pot [ Ohm ]
4.4033 , | 58935.43
3.9345 , | 35002.55
3.7954 , | 28820.12
3.7354 , | 25701.34
3.7310 , | 25536.21
3.7300 , | 25491.80
3.7300 , | 25491.80 | <- stable at target | 3.730 V

Listing 5: Serial Monitor output while adjusting potentiometer 1. A new line is printed every 500 ms.

The same procedure was used to set potentiometer 2 to VAREF = 3.325 V (Section 4.5).

### 4.4. Stage 3: Unity-Gain Difference Amplifier

### 4.4.1. Circuit Description and Pin Assignment

The op-amp is powered from a single 5 V supply: its positive supply pin goes to the 5 V rail and its negative supply pin to GND. Four 1 MΩ resistors form the difference amplifier of Figure 5:

- Rin,inv (1 MΩ): from the Vth node (Stage 1 output) to the inverting input (V−). It carries the thermistor signal.
- RF (1 MΩ): from the output back to V−. Together with Rin,inv it sets the inverting gain to −RF /Rin,inv = −1.
- Rin,non (1 MΩ): from the potentiometer 1 wiper (Vref = 3.73 V) to the non-inverting input (V+).
- Rgnd (1 MΩ): from V+ to GND. This resistor is needed so that both inputs see the same resistor network. Without it, the two inputs would have different gains and the output would not be Vref − Vth.

### 4.4.2. Wiring on the Breadboard

- The op-amp sits across the centre gap of the breadboard, so each row of pins is on its own side and no pins are shorted together.
- Power: op-amp VCC+ pin → 5 V rail; VCC- pin → GND rail.
- Inverting path: Vth row

Rin,inv −−−→ V− pin row RF −−→ output pin row.

- Non-inverting path: potentiometer 1 wiper row

Rin,non −−−−→ V+ pin row

Rgnd −−→ GND

rail.

- Output: op-amp output row → Arduino A0 through a short jumper. This is the ADC input.

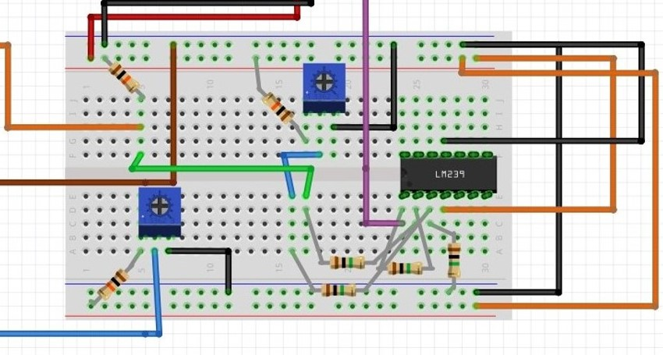
[picture p18: figure]

Figure 19: Stage 3 difference amplifier wiring. All four resistors are 1 MΩ. Inverting input: Vth from Stage 1. Non-inverting input: Vref = 3.73 V from Stage 2. Output to Arduino A0.

### 4.4.3. Choice of 1 MΩ Resistors

The 1 MΩ value comes from the loading requirement (Section 2.3.4). The Thévenin impedance of the divider, RTh = R1∥Rth, changes with temperature and is largest at 0 °C, where Rth = 29,498 Ω:

RTh,max =

10,000 × 29,498
10,000 + 29,498
= 7,468 Ω | (22)

Table 3: Thévenin source impedance of the thermistor divider at each calibration temperature.

T (°C) Rth (Ω) RTh = R1∥Rth (Ω)

0.0 | 29 498 | 7 468
33.2 | 7 241 | 4 200
34.4 | 6 832 | 4 059
35.3 | 6 585 | 3 971
37.0 | 6 135 | 3 802
37.8 | 5 945 | 3 728
38.2 | 5 892 | 3 708
90.0 | 1 136 | 1 020

### 4.4.4. Verification of the 10× Impedance Rule

Applying Equation (10) to the worst case:

10 × RTh,max = 10 × 7,468 = 74,680 Ω | (23)
Zin = 1,000,000 Ω ≫ 74,680 Ω ✓ | (margin factor = 13.4) | (24)

### 4.4.5. Loading Error at 0 °C

Using Equation (9):

εV = 3.7341 ×

7,468
1,000,000
= 27.9 mV | (25)

Converting to temperature with the divider sensitivity at 0 °C:

dVth
dT
0 °C

= Vcc ·

R1 (dR/dT)
(R1 + Rth)

2

= 5.0 ×

10,000 × (−1,415)
(39,498)²

= −45.3 mV/K (26)

εT =

27.9 mV
45.3 mV/K ≈ 0.62 °C | (27)

This is a fixed bias. With 100 kΩ resistors the error would be about 0.28 V (about 6 °C), and with 10 kΩ resistors it would be more than a volt.

### 4.4.6. Gain Stage vs. External ADC Reference

Another option would be to give the difference amplifier a gain of G = 5.0/3.325 = 1.504, so that its output covers the full 0–5 V ADC range and no AREF circuit is needed. This was considered and rejected for the following reasons:

1. Output swing on a single supply. The op-amp runs from a single 5 V rail, and even rail-to-rail op-amps stop some tens of millivolts below the supply, so an output of exactly 5.0 V cannot be reached.
2. Non-standard resistor values. G = 1.504 needs RF = 1.504 Rin, which is 1,504 kΩ for Rin = 1 MΩ. This is not an E24 or E96 value, so two resistors would have to be combined in series, which adds wiring and another tolerance error.
3. Common-mode rejection. The CMRR of a difference amplifier depends on how well the resistor ratios on its two inputs match. Matching a non-standard ratio built from combined resistors is harder than matching four equal resistors.
4. The AREF approach is simpler. Setting VAREF = 3.325 V uses all 1023 ADC steps without changing the amplifier. The second potentiometer needs no extra IC, and the amplifier keeps its equal-resistor design.

### 4.5. Stage 4: External ADC Reference (3.325 V)

### 4.5.1. Circuit Description

A second trimmer potentiometer provides the 3.325 V external reference for the ADC. This value is the amplifier output that the model predicts at 100 °C (Equation (21)), so ADC full scale (count 1023) corresponds to 100 °C.

### 4.5.2. Wiring on the Breadboard

- End terminals → 5 V and GND rails: same as potentiometer 1.
- Wiper → 5 kΩ protection resistor: the wiper is connected to AREF through a 5 kΩ resistor. If the firmware runs without analogReference(EXTERNAL), the external voltage is connected against the internal reference, and this resistor limits the current in that case.
- 5 kΩ resistor → AREF pin: a jumper goes from the other end of the resistor to the AREF pin.
- Wiper → Arduino A1 (optional monitor): a second jumper from the wiper to A1 lets the live voltage reader show the voltage while it is being set.

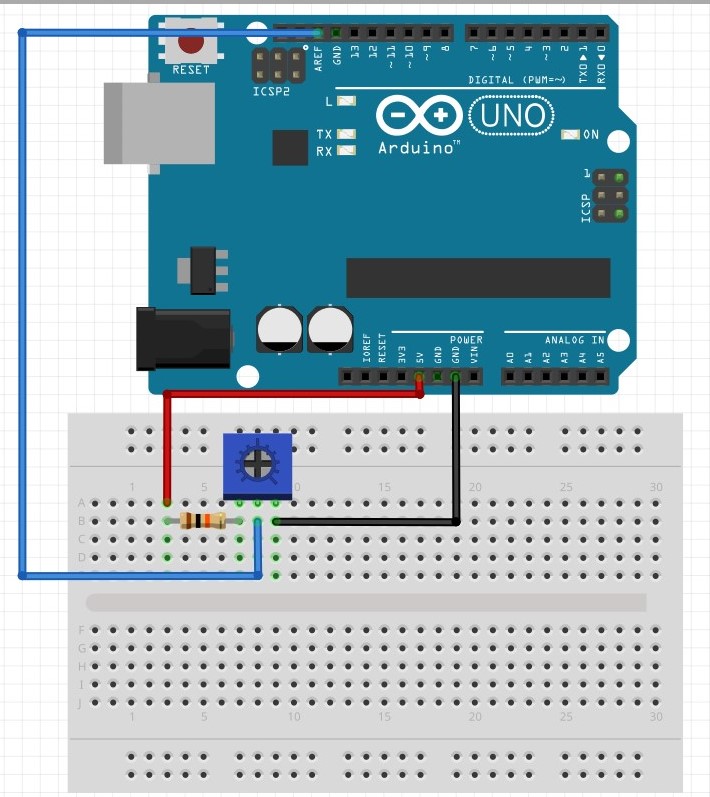
[picture p19: figure]

Figure 20: Stage 4 AREF wiring, with the 5 kΩ protection resistor between the potentiometer wiper and the AREF pin.

The resulting ADC step size is:

∆V =

VAREF
1023

=

3.325
1023
= 3.25 mV/step | (28)

compared with 4.89 mV per step with the default 5 V reference.

### 4.6. Full Assembled Circuit

Figure 21 shows the hand-drawn schematic and the assembled breadboard circuit. The schematic (Figure 21a) follows the signal from the 5 V supply through the voltage divider and the thermistor, then through the op-amp and its four 1 MΩ resistors, to the Arduino A0 input. The external AREF supply is drawn separately.

The breadboard (Figure 21b) follows the same order from left to right. The thermistor probe leaves the board at the far left toward the bath, the 10 kΩ resistor and potentiometer 1 (3.73 V reference) are on the left, the op-amp is in the middle with its four 1 MΩ resistors around it, potentiometer 2 and the 5 kΩ AREF resistor are on the right, and the Arduino Uno is connected at the far right.

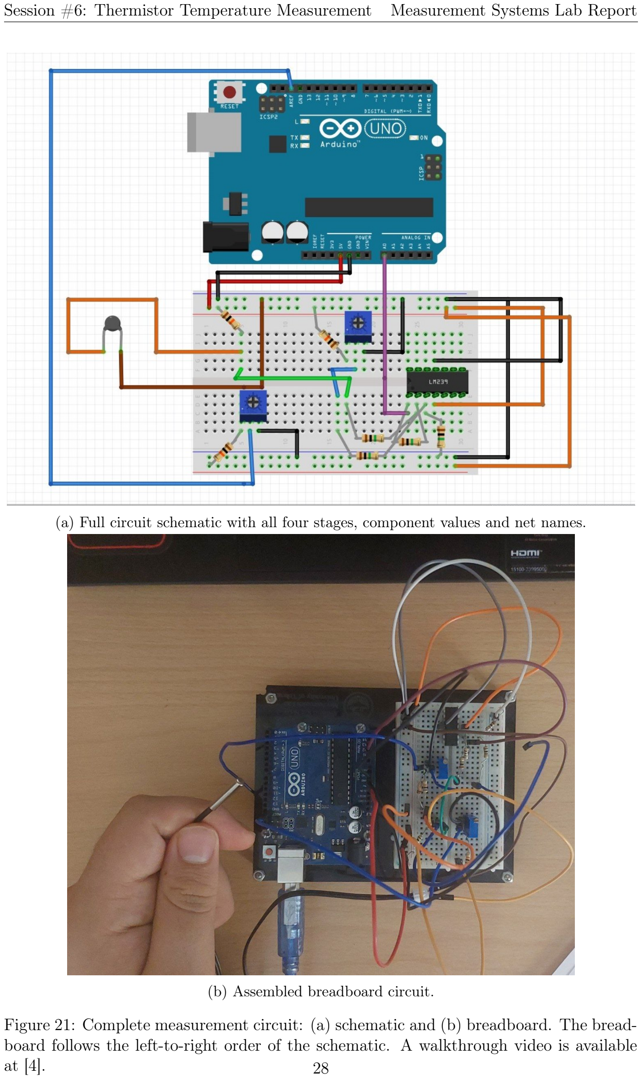
[picture p20: page 29]

(a) Full circuit schematic with all four stages, component values and net names.
(b) Assembled breadboard circuit.

Figure 21: Complete measurement circuit: (a) schematic and (b) breadboard. The breadboard follows the left-to-right order of the schematic. A walkthrough video is available
at [4]. | 28

## 5. Firmware Implementation

### 5.1. AREF Safety Requirement

In the firmware, analogReference(EXTERNAL) has to be called at the start of setup (), before any analogRead(). If analogRead() runs while the default internal reference is selected and an external voltage is connected to AREF, the internal reference and the external source are connected together, which can damage the ADC. Calling analogReference(EXTERNAL) first avoids this. The firmware also discards the first reading after the reference is changed.

### 5.2. Signal-Chain Inversion Logic

The firmware undoes each stage of the signal chain in reverse order:

Listing 6: Signal-chain inversion functions. Each function undoes one hardware stage.

1 | float reconstruct_Vtherm ( float v_adc ) { | // undo Stage 3
2 | return V_FIXED_REF - v_adc ;
3 | }

4
5 | float compute_Rtherm ( float v_therm ) { | // undo Stage 1
6 | if ( v_therm <= 0.01 f) v_therm = 0.01 f;
7 | if ( v_therm >= 4.99 f) v_therm = 4.99 f;
8 | return R_SERIES * ( v_therm / ( VCC - v_therm )) ;
9 | }

10
11 | float compute_Temperature ( float R_therm ) { | // beta model
12 | float inv_T = (1.0 f / T0_K ) + ( logf ( R_therm / R0) / BETA ) ;
13 | return (1.0 f / inv_T ) - 273.15 f;
14 | }

The full chain is:

Vadc =

ADC
1023

·VAREF

undo Stage 3
−−−−−−−→ Vth = Vref−Vadc

undo Stage 1
−−−−−−−→ Rth = R1 ·

Vth
Vcc − Vth

β-model
−−−−→ T
(29)

### 5.3. Firmware Constants and Their Origins

Each constant in the firmware comes from a calibration step or a design value:

Table 4: Firmware constants and where they come from.

Constant | Value | Type | Source
V_AREF | 3.325 V | Derived | Model extrap. at 100 °C (Eq. (21))
V_FIXED_REF 3.730 V | Measured Ice bath SS mean (Fig. 8)
R_SERIES | 10 000 Ω | Nominal | Fixed divider resistor
VCC | 5.0 V | Nominal | Arduino 5 V rail
R0 | 9835.46 Ω Fitted | MATLAB polyfit (Eq. (16))
BETA | 3578.29 K Fitted | MATLAB polyfit (Eq. (16))
T0_K | 298.15 K | Fixed | Reference temperature (25 °C)

## 6. Results and Verification

### 6.1. Verification Procedure

After the final firmware was uploaded, the system was checked at two points:

1. Ice bath (0 °C): the probe was put back into the same ice bath used for calibration, and the Serial Monitor was watched until the reading settled. A correctly calibrated system should show 0 ± εT °C, where εT ≈ 0.62 °C is the expected loading error (Equation (27)).
2. Mixed bath with thermometer (34.4 °C): the probe was placed in a stable mixed bath together with the medical thermometer, and the two readings were compared.

### 6.2. Verification Results

Ice bath:

V_adc , | V_th , | R_th , | Temp_C
0.0161 , | 3.7139 , | 28836.59 , | 0.44
0.0161 , | 3.7139 , | 28836.59 , | 0.44
0.0163 , | 3.7137 , | 28824.11 , | 0.44
0.0161 , | 3.7139 , | 28836.59 , | 0.44

Listing 7: Serial Monitor output in the ice bath during the final check. The system reads +0.44 °C instead of 0.00 °C, which is within the predicted loading offset of 0.62 °C.

The +0.44 °C offset is within the predicted 0.62 °C loading error.

Mixed bath at 34.4 °C:

V_adc , | V_th , | R_th , | Temp_C
1.6884 , | 2.0416 , | 6922.11 , | 34.32
1.6884 , | 2.0416 , | 6922.11 , | 34.32
1.6933 , | 2.0367 , | 6887.82 , | 34.38
1.6884 , | 2.0416 , | 6922.11 , | 34.32

Listing 8: Serial Monitor output in the 34.4 °C mixed bath. The firmware reads 34.32 °C, while the medical thermometer reads 34.4 °C, a difference of 0.08 °C.

### 6.3. Summary of Verification Accuracy

Table 5: Final verification results.

Test | Ref. (°C) Firmware (°C) Error (°C) Reference type
Ice bath | 0.00 | +0.44 | +0.44 | Thermodynamic fixed point
Mixed bath | 34.4 | 34.32 | −0.08 | Medical thermometer

## 7. Discussion

### 7.1. Model Validity and Calibration Density

The β-parameter model is an approximation that works well over moderate temperature ranges. It captures the main exponential behaviour of NTC thermistors but leaves out higher-order terms that matter over ranges much wider than about 100 °C. For the 0– 100 °C range used here, the two-parameter model is adequate [1].

A bigger issue is how unevenly the calibration points are spread. Six of the eight points lie within 5 °C (33–38 °C), and their xi = 1/Ti−1/T0 values differ by only about 5×10⁻⁵ K⁻¹ ,
so they add little independent information. β and R0 are therefore set mostly by the two end points at 0 °C and 90 °C. This does not hurt the accuracy at those two points, but the model between them is checked by only a few measurements. Additional points at 10, 20, 50 and 70 °C, measured with a thermocouple, would test the model over the whole range and make the fit residuals more meaningful.

### 7.2. ADC Resolution Improvement

Table 6: ADC use with the default 5 V reference and with the VAREF = 3.325 V external reference.

Parameter | Default (5 V) | External (3.325 V)
AREF voltage | 5.000 V | 3.325 V
Signal span (0–100 °C) | 0–3.325 V | 0–3.325 V
ADC steps used | 680 / 1023 (66.5%) | 1023 / 1023 (100%)
Voltage per step | 4.89 mV | 3.25 mV
Resolution improvement | – | +33.5%
Additional steps | – | +343 steps

### 7.3. Error Sources and Analysis

1. Loading error (0.62 °C at 0 °C). The 27.9 mV offset caused by the finite 1 MΩ input impedance (Equation (27)) is a fixed bias, so averaging cannot remove it. An instrumentation amplifier (Section 2.6) would remove it.
2. Few and unevenly spread calibration points. As discussed in Section 7.1, six of the eight points are within a 5 °C band, which makes the model less reliable outside that band. More points spread over 0–100 °C would reduce this error.
3. Potentiometer setting accuracy. Both Vref and VAREF were set by hand using the live voltage reader, which relies on the Arduino’s own 10-bit ADC (about 4.89 mV per step at 5 V). A 10 mV error in Vref shifts every reconstructed Vth by 10 mV, which is about 0.2 °C at 25 °C. Setting the voltages with a precision multimeter would reduce this error.
4. Medical thermometer accuracy. Clinical thermometers are designed for about 35–42 °C and may have a systematic error of ±0.3–0.5 °C near the edges of their range. The ice bath does not have this problem, since it is a fixed point.
5. ADC quantisation. At 3.25 mV per step and |dVth/dT| ≈ 45.3 mV/K at 0 °C (Equation (26)), the smallest temperature step the ADC can resolve is 3.25/45.3 ≈ 0.07 °C near 0 °C.
6. Thermistor self-heating. The 5 V supply drives about 250 µA through the thermistor at 25 °C, which dissipates about 0.6 mW and warms it slightly in still air. In a stirred water bath the heat transfer is high enough that this error is negligible.
7. Op-amp output near 0 V. On a single 5 V supply the op-amp output cannot reach exactly 0 V. Near 0 °C the output is only about 16 mV (Listing 7), so this may add a small offset there.
8. Model extrapolation. VAREF was found by evaluating the model at 100 °C, 10 °C above the highest calibration point. Over such a short extrapolation the β-model behaves well, but any error in β has a slightly larger effect than inside the calibrated range. Measuring a point at 100 °C with a thermocouple would remove this uncertainty.
9. Uncertainty of the 90 °C point. The boiling-water temperature was estimated rather than measured, because it is outside the medical thermometer’s range. Since β is set mostly by the 0 °C and 90 °C points (Section 7.1), an error in this value shifts β directly. Measuring this point with a thermocouple would remove this uncertainty.

## 8. Conclusion

A complete NTC thermistor thermometer was designed, calibrated and tested. The only reference instrument was a medical thermometer with a 32–43 °C range, so the intermediate calibration points are all close to body temperature. The 0 °C and 90 °C end points were taken without the thermometer, using an ice bath and boiling water. The 90 °C value was estimated from Tehran’s altitude (about 1200–1500 m) and the cooling of the water after the kettle was unplugged.

The ice bath reading (Vth = 3.73 V, Figure 8) set the difference amplifier reference Vref. The ADC reference was not taken from the 90 °C measurement. Instead, the fitted β-model was evaluated at 100 °C to find the largest expected amplifier output (Equation (21)):

VAREF = Vref − Vth(100 °C) = 3.730 − 0.405 = 3.325 V

This maps ADC full scale (count 1023) to 100 °C instead of the measured 90 °C, with a resolution of 3.25 mV per step, 33.5% finer than with the 5 V default. A gain stage that stretches the output to 0–5 V was not used: the single-supply op-amp cannot reach 5 V, the non-standard resistor values would make resistor matching harder, and the AREF approach uses the ADC just as fully with a simpler amplifier (Section 4.4.6).

The 1 MΩ amplifier resistors meet the 10× impedance rule with a margin of 13.4 (Equation (24)), which leaves a worst-case loading error of 0.62 °C at 0 °C. In the final test (Section 6.2), the system read +0.44 °C in the ice bath (Listing 7) and 34.32 °C in a bath where the medical thermometer read 34.4 °C (Listing 8), a difference of 0.08 °C.

## Acknowledgements

I would like to thank Dr. Ali Sadighi for designing the course, providing the theory needed for the lab, and his clear teaching throughout the semester. I also thank the teaching assistants, Mohammad Jadidi and Erfun Bayat Sarmadi, for their help during the lab sessions.

## References

[1] M. Robati, A. Mashhadireza, S. Sehhat, M. Jadidi, E. B. Sarmadi, “Lab Session 06: Temperature Measurement System,” Mechatronics Laboratory Manual, University of Tehran, ver. 1.2, Dec. 2025.
[2] D. G. Alciatore, Introduction to Mechatronics and Measurement Systems, 4th ed., McGraw-Hill, 2012.
[3] Analog Devices, “AD620 Low Cost Instrumentation Amplifier,” Data Sheet. [Online]. Available: https://www.analog.com/media/en/technical-documentation/data-sheets/AD620.pdf (https://www.analog.com/media/en/technical-documentation/data-sheets/AD620.pdf)
[4] R. Amini, “NTC Thermistor Temperature Measurement System: Circuit Walkthrough and Experimental Demonstration,” Supplementary Video, Lab Session 06, University of Tehran, Feb. 2026. [Online]. Available: Google Drive (click to open video) (https://drive.google.com/file/d/1PbSO4Ykz_4UzDc53VSuvN0FztdAycL6p/view?usp=drive_link)
[5] R. Amini, “NTC Thermistor Temperature Measurement and Calibration System,” GitHub repository, 2026. [Online]. Available: https://github.com/RoozbehAmini/NTC-Thermistor-Temperature-Measurement-and-Calibration-System (https://github.com/RoozbehAmini/NTC-Thermistor-Temperature-Measurement-and-Calibration-System)

# Appendices

All the code below is also available in the project’s GitHub repository [5].

## A. Arduino Calibration Logger (50 Hz, 60 s)

Listing 9: Calibration logger (Arduino/calibration_logger). Streams t_s, adc, volt_V, R_therm_Ohm at 50 Hz for 60 s, then stops.

1 | /*
2 | * Calibration Logger (50 Hz , 60 s)
3 | * Measurement Systems Lab , Session 06 - University of Tehran
4 | *
5 | * Wiring ( calibration stage , no amplifier yet ):
6 | * | 5V - -[10k] - -+ - -[ NTC thermistor ] - - GND
7 | * | |
8 | * | + - - > A0
9 | *
10 | * Samples A0 every 20 ms for 60 s and streams CSV over serial :
11 | * | t_s , adc , volt_V , R_therm_Ohm
12 | * then stops . Opening the serial port (e.g. from the MATLAB script )
13 | * resets the Uno , which starts a fresh 60 s log .
14 | */

15
16 | const int | THERM_PIN | = A0;
17 | const float | VREF | = 5.0 f; | // default ADC reference (5
| V rail )
18 | const float | R_FIXED | = 10000.0 f; | // series resistor on the 5
| V side
19 | const unsigned long DURATION_MS = 60000 UL; | // 60 s record
20 | const unsigned long Ts_ms | = 20 UL; | // 20 ms -> 50 Hz

21
22 | void setup () {
23 | Serial . begin (115200) ;
24 | Serial . println ("t_s ,adc ,volt_V , R_therm_Ohm ") ;
25 | }

26
27 | void loop () {
28 | static bool done = false ;
29 | if ( done ) return ;

30
31 | unsigned long t0 | = millis () ;
32 | unsigned long next = t0;

33
34 | while ( millis () - t0 < DURATION_MS ) {
35 | if ( millis () >= next ) {
36 | next += Ts_ms ;
37 | float t_s = ( millis () - t0) / 1000.0 f;
38 | int | adc = analogRead ( THERM_PIN ) ;
39 | float v | = adc * VREF / 1023.0 f;

40
41 | // Divider inversion ( thermistor on the GND side ): R = R1 * V / (
| Vcc - V)
42 | float Rth = (v > 0.01 f && v < VREF - 0.01 f)
43 | ? R_FIXED * v / ( VREF - v)

44 | : 0.0f;

45
46 | Serial . print (t_s , 4) ; Serial . print (",") ;
47 | Serial . print (adc) ; | Serial . print (",") ;
48 | Serial . print (v, 6) ; | Serial . print (",") ;
49 | Serial . println (Rth , 2) ;
50 | }
51 | }
52 | done = true ;
53 | }

## B. Live Voltage Reader

Listing 10: Live voltage reader (Arduino/live_voltage_reader), used to set both potentiometers. Prints Vout[V], R_pot[Ohm] every 500 ms.

1 | /*
2 | * Live Voltage Reader
3 | * Measurement Systems Lab , Session 06 - University of Tehran
4 | *
5 | * Used to set the two trimmer potentiometers :
6 | * | Pot 1 (diff -amp reference , target 3.730 V): wiper -> A2
7 | * | Pot 2 ( ADC reference , | target 3.325 V): wiper -> A1
8 | * Change PIN_ANALOG to match the pot you are adjusting .
9 | *
10 | * Prints | Vout [V] , R_pot [Ohm ] | every 500 ms (2 Hz).
11 | *
12 | * Note : R_pot uses the divider formula R = R_FIXED * V / ( Vcc - V), so
it
13 | * is only meaningful when an unknown resistor sits under a 10k fixed
14 | * resistor (e.g. the thermistor divider ). When setting a pot , read Vout
only .

15 */

16
17 | const int | PIN_ANALOG = A2; | // A2 = pot 1 , A1 = pot 2
18 | const float VREF | = 5.0f;
19 | const int | ADC_RES | = 1023;
20 | const float R_FIXED | = 10000.0 f;

21
22 | void setup () {
23 | analogReference ( DEFAULT ) ;
24 | Serial . begin (9600) ;
25 | while (! Serial ) { ; }
26 | Serial . println (" Vout [V] , R_pot [ Ohm ]");
27 | }

28
29 | void loop () {
30 | int | adc | = analogRead ( PIN_ANALOG ) ;
31 | float Vout | = ( float )adc * VREF / ( float ) ADC_RES ;
32 | float R_pot = -1.0f; | // -1 = out of
range
33 | if ( Vout > 0.01 f && Vout < VREF - 0.01 f) | // avoid divide -by -
zero at full scale
34 | R_pot = R_FIXED * ( VREF / ( VREF - Vout ) - 1.0 f) ;

35
36 Serial . print (Vout , 4) ; Serial . print (",") ;

37 | Serial . println (R_pot , 2) ;
38 | delay (500) ;
39 | }

## C. MATLAB Calibration Acquisition Script

Listing 11: Matlab/acquire_calibration_point.m: records one 60 s calibration point, extracts the steady-state mean, saves the raw trace, appends the point to the master list and plots the traces.

1 | % ACQUIRE_CALIBRATION_POINT
2 | % Measurement Systems Lab , Session 06 - University of Tehran
3 | %
4 | % Records one 60 s calibration point from the Arduino calibration logger
5 | % ( arduino / calibration_logger ), extracts the steady - state mean from the
6 | % last 10 s, saves the raw trace , appends the point to the master list ,
7 | % and plots the voltage and resistance traces .
8 | %
9 | % Usage : upload calibration_logger to the Uno , put the probe in the bath
,
10 | % wait until the reference thermometer is stable , then run this script .
11 | % Opening the port resets the Uno , which starts a fresh 60 s log .
12 | %
13 | % Requires MATLAB R2019b + ( serialport ).

14
15 clear ; clc ; close all ;

16
17 | port | = " COM4 "; | % change to your Arduino port
18 | baud | = 115200;
19 | duration | = 60; | % s
20 | steady_win = 10; | % s, steady - state window at the end of the
record

21
22 | % Output folder : ../ data relative to this script ( falls back to pwd )
23 | script_dir = fileparts ( mfilename (’fullpath ’) ) ;
24 | if isempty ( script_dir ) , script_dir = pwd ; end
25 | data_dir = fullfile ( script_dir , ’.. ’, ’data ’) ;
26 | if ~ exist ( data_dir , ’dir ’) , mkdir ( data_dir ) ; end

27
28 ref_temp = input (’>> Enter bath temperature ( deg C): ’) ;

29
30 | s = serialport (port , baud ) ;
31 | configureTerminator (s, "LF ") ;
32 | flush (s) ; pause (1) ;
33 | if s. NumBytesAvailable > 0 , readline (s) ; end | % drop header / partial
line

34
35 | count = 0;
36 | buf | = zeros ( duration *60 , 3) ; | % headroom above 50 Hz x 60 s
37 | tic;
38 | while toc < duration
39 | if s. NumBytesAvailable > 0
40 | vals = sscanf ( readline (s) , "%f ,%d ,%f ,%f"); | % t_s , adc , volt_V ,
R_therm_Ohm
41 | if numel ( vals ) == 4
42 | count = count + 1;

43 | buf (count , :) = [ vals (1) , vals (3) , vals (4) ];
44 | end
45 | end
46 | end
47 | delete (s) ; clear s;

48
49 | T = buf (1: count , 1) ;
50 | V = buf (1: count , 2) ;
51 | R = buf (1: count , 3) ;

52
53 | %% Steady - state extraction
54 | t_max | = max (T) ;
55 | ss | = T >= ( t_max - steady_win ) ;
56 | v_mean = mean (V(ss) ) ;
57 | r_mean = mean (R(ss) ) ;
58 | r_std | = std (R(ss) ) ;

59
60 | %% Save full time series
61 | tag | = strrep ( sprintf (’%.1 f’, ref_temp ) , ’.’, ’p’) ;
62 | raw_file = fullfile ( data_dir , sprintf (’cal_raw_ %sC. csv ’, tag ) ) ;
63 | fid = fopen ( raw_file , ’w’) ;
64 | fprintf (fid , ’t_s ,volt_V , R_therm_Ohm \n’) ;
65 | for k = 1: count
66 | fprintf (fid , ’%.4f ,%.6f ,%.2 f\n’, T(k) , V(k) , R(k) ) ;
67 | end
68 | fclose ( fid) ;

69
70 | %% Append to master list
71 | master = fullfile ( data_dir , ’ calibration_master_list . csv ’);
72 | if ~ isfile ( master )
73 | fid = fopen (master , ’w’) ;
74 | fprintf (fid , ’T_C ,V_mean , R_mean \n’) ;
75 | fclose (fid ) ;
76 | end
77 | fid = fopen (master , ’a’) ;
78 | fprintf (fid , ’%.2f ,%.6f ,%.6 f\n’, ref_temp , v_mean , r_mean ) ;
79 | fclose ( fid) ;

80
81 | %% Annotated plots
82 | figure (’Color ’, ’w’, ’Position ’, [100 100 1200 500]) ;
83 | subplot (2 ,1 ,1) ;
84 | plot (T, V, ’Color ’, [.75 .75 .75]) ; hold on;
85 | plot (T, movmean (V, 50) , ’b’, ’LineWidth ’, 1.8) ; | % 50 samples = 1 s
86 | yl = ylim ;
87 | patch ([ t_max - steady_win t_max t_max t_max - steady_win ] , ...
88 | [yl (1) yl (1) yl (2) yl (2) ] , [0.18 0.78 0.18] , ...
89 | ’FaceAlpha ’, .12 , ’EdgeColor ’, ’none ’) ;
90 | yline ( v_mean , ’r- -’, ’LineWidth ’, 1.6 , ...
91 | ’Label ’, sprintf (’V_{ss }=%.4 f V’, v_mean ) , ...
92 | ’ LabelHorizontalAlignment ’, ’left ’, ’ LabelVerticalAlignment ’, ’
bottom ’) ;
93 | ylabel (’V_{th} (V)’) ; grid on; box on;
94 | legend ({ ’Raw 50 Hz ’, ’Smoothed 1 s’, ’Steady window ’} , ’Location ’, ’best
’) ;
95 title ( sprintf (’Voltage trace at %.1 f degC ’, ref_temp ) );

96
97 | subplot (2 ,1 ,2) ;
98 | plot (T, R, ’Color ’, [.85 .33 .10] , ’LineWidth ’, 1.4) ; hold on;

99 | yl2 = ylim ;
100 | patch ([ t_max - steady_win t_max t_max t_max - steady_win ] , ...
101 | [ yl2 (1) yl2 (1) yl2 (2) yl2 (2) ] , [0.18 0.78 0.18] , ...
102 | ’FaceAlpha ’, .12 , ’EdgeColor ’, ’none ’);
103 | yline ( r_mean , ’k- -’, ’LineWidth ’, 1.6 , ...
104 | ’Label ’, sprintf (’R_{ss }=%.2 f Ohm ’, r_mean ) , ...
105 | ’ LabelHorizontalAlignment ’, ’left ’, ’ LabelVerticalAlignment ’, ’
bottom ’) ;
106 | xlabel (’Time (s)’); ylabel (’R_{th} ( Ohm )’) ; grid on; box on;
107 | title ( sprintf (’Resistance trace at %.1 f degC ’, ref_temp ) ) ;
108 | sgtitle ( sprintf (’SS: V =%.4 fV | R =%.2 fOhm | sigma =%.3 fOhm ’, ...
109 | v_mean , r_mean , r_std ) , ’ FontWeight ’, ’bold ’) ;

110
111 fprintf (’Done : %.1 fC | %.4 fV | %.2 fOhm \n’, ref_temp , v_mean , r_mean );

## D. MATLAB Model Fitting and Characteristic Plots

Listing 12: Matlab/fit_beta_model.m: loads the calibration master list, fits the linearised β model, prints the fit residuals, extrapolates to 100 °C to find VAREF, and saves the calibration and characteristic plots.

1 | % FIT_BETA_MODEL
2 | % Measurement Systems Lab , Session 06 - University of Tehran
3 | %
4 | % Loads the calibration master list , fits the linearised beta model
5 | % | ln(R) = ln(R0) + beta * (1/ T - 1/ T0)
6 | % by least squares , extrapolates to 100 degC to get V_AREF , and saves
the
7 | % calibration - curve and expected - characteristics figures .
8 | %
9 | % Data : ../ data / calibration_master_list . csv ( written by
10 | % acquire_calibration_point .m). If that file is missing , the eight
11 | % calibration points from the lab report are used .
12 | %
13 | % Requires MATLAB R2023a + ( xregion ); exportgraphics needs R2020a +.

14
15 clear ; clc ; close all ;

16
17 | %% Setup
18 | script_dir = fileparts ( mfilename (’fullpath ’) ) ;
19 | if isempty ( script_dir ) , script_dir = pwd ; end
20 | save_dir = fullfile ( script_dir , ’.. ’, ’figures ’) ;
21 | if ~ exist ( save_dir , ’dir ’) , mkdir ( save_dir ) ; end
22 | DPI = 300;

23
24 | %% Load data
25 | csv_path = fullfile ( script_dir , ’.. ’, ’data ’, ’ calibration_master_list .
csv ’) ;
26 | if isfile ( csv_path )
27 | data | = readmatrix ( csv_path ) ;
28 | T_C | = data (: ,1) ;
29 | R_meas = data (: ,3) ;
30 | fprintf (’Loaded %d points from %s\n’, numel ( T_C ) , csv_path ) ;
31 | else
32 | T_C | = [0.0; 33.2; 34.4; 35.3; 37.0; 37.8; 38.2; 90.0];
33 | R_meas = [29498.05; 7241.27; 6832.37; 6585.11; ...

34 | 6135.16; | 5944.50; 5892.11; 1135.84];
35 | fprintf (’Master list not found , using report Table 1 data \n’) ;
36 | end
37 | [T_C , ix] = sort ( T_C ) ;
38 | R_meas | = R_meas (ix) ;
39 | T_K | = T_C + 273.15;
40 | T0 | = 298.15;
41 | Vcc = 5.0; | R1 = 10000; | Vref = 3.730;

42
43 | %% Beta - model fit
44 | X | = (1 ./ T_K) - (1 / T0) ;
45 | Y | = log( R_meas ) ;
46 | p | = polyfit (X, Y, 1) ;
47 | Beta = p (1) ;
48 | R0 | = exp (p(2) ) ;
49 | fprintf (’Beta = %.4 f K\nR0 | = %.4 f Ohm \n’, Beta , R0) ;

50
51 | % Residuals in degC (how well the model reproduces each point )
52 | T_fit_C = 1 ./ (1/ T0 + log ( R_meas /R0) / Beta ) - 273.15;
53 | fprintf (’\n | T_ref (C) | T_model (C) | error (C)\n’) ;
54 | fprintf (’ | %8.2 f | %10.3 f | %+9.3 f\n’, [T_C , T_fit_C , T_fit_C - T_C ] ’) ;

55
56 | %% Extrapolate to 100 degC
57 | T_extrap = 100;
58 | R_100 | = R0 * exp ( Beta * (1/( T_extrap + 273.15) - 1/ T0) );
59 | Vth_100 | = Vcc * R_100 / (R1 + R_100 ) ;
60 | Vout_100 = Vref - Vth_100 ;
61 | fprintf (’\nAt 100 degC ( model extrapolation ):\n’) ;
62 | fprintf (’ | R (100) | = %.2 f Ohm \n’, R_100 ) ;
63 | fprintf (’ | Vth (100) | = %.4f V\n’, Vth_100 ) ;
64 | fprintf (’ | Vout (100) = %.4 f V --> VAREF = %.3 f V\n’, Vout_100 , Vout_100 )
;

65
66 | %% Model curve
67 | Tc | = linspace (0 , 105 , 600) ’;
68 | Tk | = Tc + 273.15;
69 | Xp | = (1 ./ Tk) - (1 / T0) ;
70 | Rm | = R0 .* exp ( Beta .* Xp);
71 | Vth_model | = Vcc .* Rm ./ (R1 + Rm) ;
72 | Vout_model = Vref - Vth_model ;
73 | Vth_data | = Vcc .* R_meas ./ (R1 + R_meas ) ;
74 | Vout_data | = Vref - Vth_data ;

75
76 | idx0 | = find (T_C == 0 , 1) ;
77 | idx90 = find (T_C == 90 , 1) ;

78
79 | %% --- FIGURE 1: Calibration Curve ---
80 | hf1 = figure (’Color ’, ’w’, ’Position ’, [50 50 1000 560] , ’Visible ’, ’on ’
) ;
81 ax1 = axes (hf1 ) ; hold on;

82
83 | h_fit | = plot (Tc , Rm , ’b-’, ’LineWidth ’, 2.2) ;
84 | h_data = scatter (T_C , R_meas , 80 , ’r’, ’filled ’, ...
85 | ’ MarkerEdgeColor ’, [0.55 0 0] , ’LineWidth ’, 1.2) ;
86 | h_ext | = scatter ( T_extrap , R_100 , 100 , [0 0.6 0] , ’d’, ’filled ’, ...
87 | ’ MarkerEdgeColor ’, [0 0.35 0] , ’LineWidth ’, 1.5) ;
88 | text ( T_extrap + 1.5 , R_100 + 300 , ...
89 | sprintf (’100 degC ( model )\nR = %.0 f Ohm ’, R_100 ) , ...

90 | ’FontSize ’, 9 , ’Color ’, [0 0.45 0]) ;

91
92 | if ~ isempty ( idx0 )
93 | text (1 , R_meas ( idx0 ) - 2200 , sprintf (’0 degC \n %.0 f Ohm ’, R_meas ( idx0
| ) ) , ...
94 | ’FontSize ’, 9 , ’Color ’, [0.5 0 0]) ;
95 | end
96 | if ~ isempty ( idx90 )
97 | text (83 , R_meas ( idx90 ) + 500 , sprintf (’90 degC %.0 f Ohm ’, R_meas (
| idx90 ) ) , ...
98 | ’FontSize ’, 9 , ’Color ’, [0.5 0 0]) ;
99 | end

100
101 | xregion (33 , 38.5 , ’FaceColor ’, [1 1 0] , ’FaceAlpha ’, 0.15 , ...
102 | ’ HandleVisibility ’, ’off ’) ;
103 | text (35.5 , 18000 , ’33 -38 degC cluster ’, ...
104 | ’ HorizontalAlignment ’, ’center ’, ’FontSize ’, 9 , ’Color ’, [0.5 0.4
| 0]) ;

105
106 | xlabel (’ Temperature ( degC )’, ’FontSize ’, 12) ;
107 | ylabel (’Thermistor Resistance ( Ohm )’, ’FontSize ’, 12) ;
108 | title ( sprintf (’Calibration Curve | Beta = %.2 f K, | R0 = %.2 f Ohm ’,
109 | Beta , R0) , ’FontSize ’, 13 , ’ FontWeight ’, ’bold ’) ;
110 | legend ([ h_fit , h_data , h_ext ] , ...
111 | ’Fitted beta - model ’, ...
112 | ’ Calibration points ’, ...
113 | ’100 degC extrapolation ( AREF basis )’, ...
114 | ’Location ’, ’northeast ’, ’FontSize ’, 10) ;
115 | grid on; box on;
116 | set(gca , ’FontSize ’, 10) ;

117
118 | exportgraphics (hf1 , fullfile ( save_dir , ’ fig_fitted_curve . png ’) , ...
119 | ’Resolution ’, DPI ) ;
120 | fprintf (’Saved : fig_fitted_curve . png \n’);
121 | close ( hf1) ;

122
123 | %% --- FIGURE 2: Expected R(T) and V_th (T) ---
124 | hf2 = figure (’Color ’, ’w’, ’Position ’, [50 50 1200 500] , ’Visible ’, ’on ’
| ) ;

125
126 | subplot (1 ,2 ,1) ; hold on;
127 | plot (Tc , Rm , ’b-’, ’LineWidth ’, 2.2) ;
128 | scatter (T_C , R_meas , 65 , ’r’, ’filled ’, ’ MarkerEdgeColor ’, ’k’) ;
129 | xlabel (’ Temperature ( degC )’, ’FontSize ’, 12) ;
130 | ylabel (’Resistance ( Ohm )’, ’FontSize ’, 12) ;
131 | title (’Expected R(T)’, ’FontSize ’, 12 , ’FontWeight ’, ’bold ’) ;
132 | legend ({ ’Fitted model ’, ’Calibration data ’} , ’Location ’, ’northeast ’,
133 | ’FontSize ’, 10) ;
134 | grid on; box on; set (gca , ’FontSize ’, 10) ;

135
136 | subplot (1 ,2 ,2) ; hold on;
137 | plot (Tc , Vth_model , ’r-’, ’LineWidth ’, 2.2) ;
138 | scatter (T_C , Vth_data , 65 , ’k’, ’filled ’) ;
139 | if ~ isempty ( idx0 )
140 | text (1.5 , Vth_data ( idx0 ) + 0.06 , ...
141 | sprintf (’%.2 f V (0 degC )’, Vth_data ( idx0 ) ) , ...

142 | ’FontSize ’, 9 , ’Color ’, [0 0.4 0]) ;
143 | end
144 | if ~ isempty ( idx90 )
145 | text (72 , Vth_data ( idx90 ) + 0.06 , ...
146 | sprintf (’%.2 f V (90 degC )’, Vth_data ( idx90 ) ) , ...
147 | ’FontSize ’, 9 , ’Color ’, [0 0.4 0]) ;
148 | end
149 | scatter ( T_extrap , Vth_100 , 80 , [0 0.6 0] , ’d’, ’filled ’, ...
150 | ’ MarkerEdgeColor ’, [0 0.35 0]) ;
151 | text ( T_extrap - 18 , Vth_100 - 0.06 , ...
152 | sprintf (’%.3f V (100 degC model )’, Vth_100 ) , ...
153 | ’FontSize ’, 9 , ’Color ’, [0 0.4 0]) ;
154 | xlabel (’ Temperature ( degC )’, ’FontSize ’, 12) ;
155 | ylabel (’V_{th} (V)’, ’FontSize ’, 12) ;
156 | title (’Expected V_{th }(T)’, ’FontSize ’, 12 , ’ FontWeight ’, ’bold ’) ;
157 | legend ({ ’Fitted model ’, ’Calibration data ’} , ’Location ’, ’northeast ’,
158 | ’FontSize ’, 10) ;
159 | grid on; box on; set (gca , ’FontSize ’, 10) ;

160
161 | sgtitle ( sprintf (’Expected Thermistor Characteristics | Beta = %.2 f K,
R0 = %.2f Ohm ’, ...
162 | Beta , R0) , ’FontSize ’, 12 , ’FontWeight ’, ’bold ’) ;

163
164 | exportgraphics (hf2 , fullfile ( save_dir , ’ fig_expected_curves . png ’) , ...
165 | ’Resolution ’, DPI ) ;
166 | fprintf (’Saved : fig_expected_curves . png \n’) ;
167 | close ( hf2) ;

## E. Final Temperature Measurement Firmware

Listing | 13: | Final | firmware | (Arduino/temperature_firmware).
analogReference(EXTERNAL) is called first. Reports Vadc, Vth, Rth and T at 2 Hz. The calibration constants come from the MATLAB fit (Appendix D), and VAREF = 3.325 V comes from the model extrapolation to 100 °C (Eq. (21)).
1 | /*
2 | * Final Temperature Measurement Firmware
3 | * Measurement Systems Lab , Session 06 - University of Tehran
4 | *
5 | * Forward signal chain :
6 | * | 5V - -[10k] - -+ - -[ Thermistor ]- - GND
7 | * | |
8 | * | Vth --> Diff - Amp (V -)
9 | * | Pot -1 (3.730 V) --> Diff - Amp (V+)
10 | * | Diff - Amp output --> A0
11 | * | Pot -2 (3.325 V) --> [5k] --> AREF
12 | *
13 | * Firmware inversion :
14 | * | V_adc = (ADC / 1023) * V_AREF | ( undo ADC scaling )
15 | * | V_th | = V_FIXED_REF - V_adc | ( undo Stage 3 diff amp )
16 | * | R_th | = R_SERIES * V_th / ( Vcc - V_th ) ( undo Stage 1 divider )
17 | * | T[C] | = 1 / (1/ T0 + ln(R/R0)/ beta ) - 273.15
18 | *
19 | * V_AREF = 3.325 V derived from the beta model at 100 C:
20 | * | R (100 C) = 881.4 Ohm -> Vth (100 C) = 0.405 V

21 | * | Vout (100 C) = 3.730 - 0.405 = 3.325 V -> AREF
22 | *
23 | * AREF note : the AREF pin has an internal ~32 k resistance , so the 5k
24 | * protection resistor forms a divider with it. Set V_AREF to the
voltage
25 * measured with a multimeter AT THE AREF PIN while this sketch is running ,
26 | * not the voltage at the pot wiper .
27 | */

28
29 | // --- Calibration constants ( from MATLAB beta - model fit ) ---
30 | const float V_AREF | = 3.325 f; | // model extrapolation to 100 C (
see AREF note )
31 | const float V_FIXED_REF = 3.730 f; | // Pot -1: V_th at 0 C ( ice bath )
32 | const float R_SERIES | = 10000.0 f;
33 | const float VCC | = 5.0f;
34 | const float R0 | = 9835.46 f; | // Ohm at 25 C
35 | const float BETA | = 3578.29 f; | // K
36 | const float T0_K | = 298.15 f; | // 25 C

37
38 const int SENSOR_PIN = A0;

39
40 | float reconstruct_Vtherm ( float v_adc ) ;
41 | float compute_Rtherm ( float v_therm ) ;
42 | float compute_Temperature ( float R_therm ) ;

43
44 | void setup () {
45 | analogReference ( EXTERNAL ) ; | // MUST be first , before any
analogRead ()
46 | analogRead ( SENSOR_PIN ) ; | // discard first reading after
reference change
47 | Serial . begin (9600) ;
48 | while (! Serial ) { ; }
49 | Serial . println ("V_adc ,V_th ,R_th , Temp_C ") ;
50 | }

51
52 | void loop () {
53 | int | adc | = analogRead ( SENSOR_PIN );
54 | float v_adc | = ( float )adc / 1023.0 f * V_AREF ;
55 | float v_therm = reconstruct_Vtherm ( v_adc ) ;
56 | float R_therm = compute_Rtherm ( v_therm ) ;
57 | float tempC | = compute_Temperature ( R_therm ) ;

58
59 | Serial . print (v_adc , 4) ; | Serial . print (",") ;
60 | Serial . print ( v_therm , 4) ; Serial . print (",") ;
61 | Serial . print ( R_therm , 2) ; Serial . print (",") ;
62 | Serial . println (tempC , 2) ;

63
64 | delay (500) ; | // 2 Hz
65 | }

66
67 | float reconstruct_Vtherm ( float v_adc ) {
68 | return V_FIXED_REF - v_adc ;
69 | }

70
71 | float compute_Rtherm ( float v_therm ) {
72 | if ( v_therm <= 0.01 f) v_therm = 0.01 f;
73 | if ( v_therm >= 4.99 f) v_therm = 4.99 f;

74 | return R_SERIES * ( v_therm / ( VCC - v_therm ) ) ;
75 | }

76
77 | float compute_Temperature ( float R_therm ) {
78 | float inv_T = (1.0 f / T0_K ) + ( logf ( R_therm / R0) / BETA ) ;
79 | return (1.0 f / inv_T ) - 273.15 f;
80 | }
